oclyke/Laptop/Hardware/15TB.brd

## EAGLE design Hardware/15TB.brd (2020-11-16)

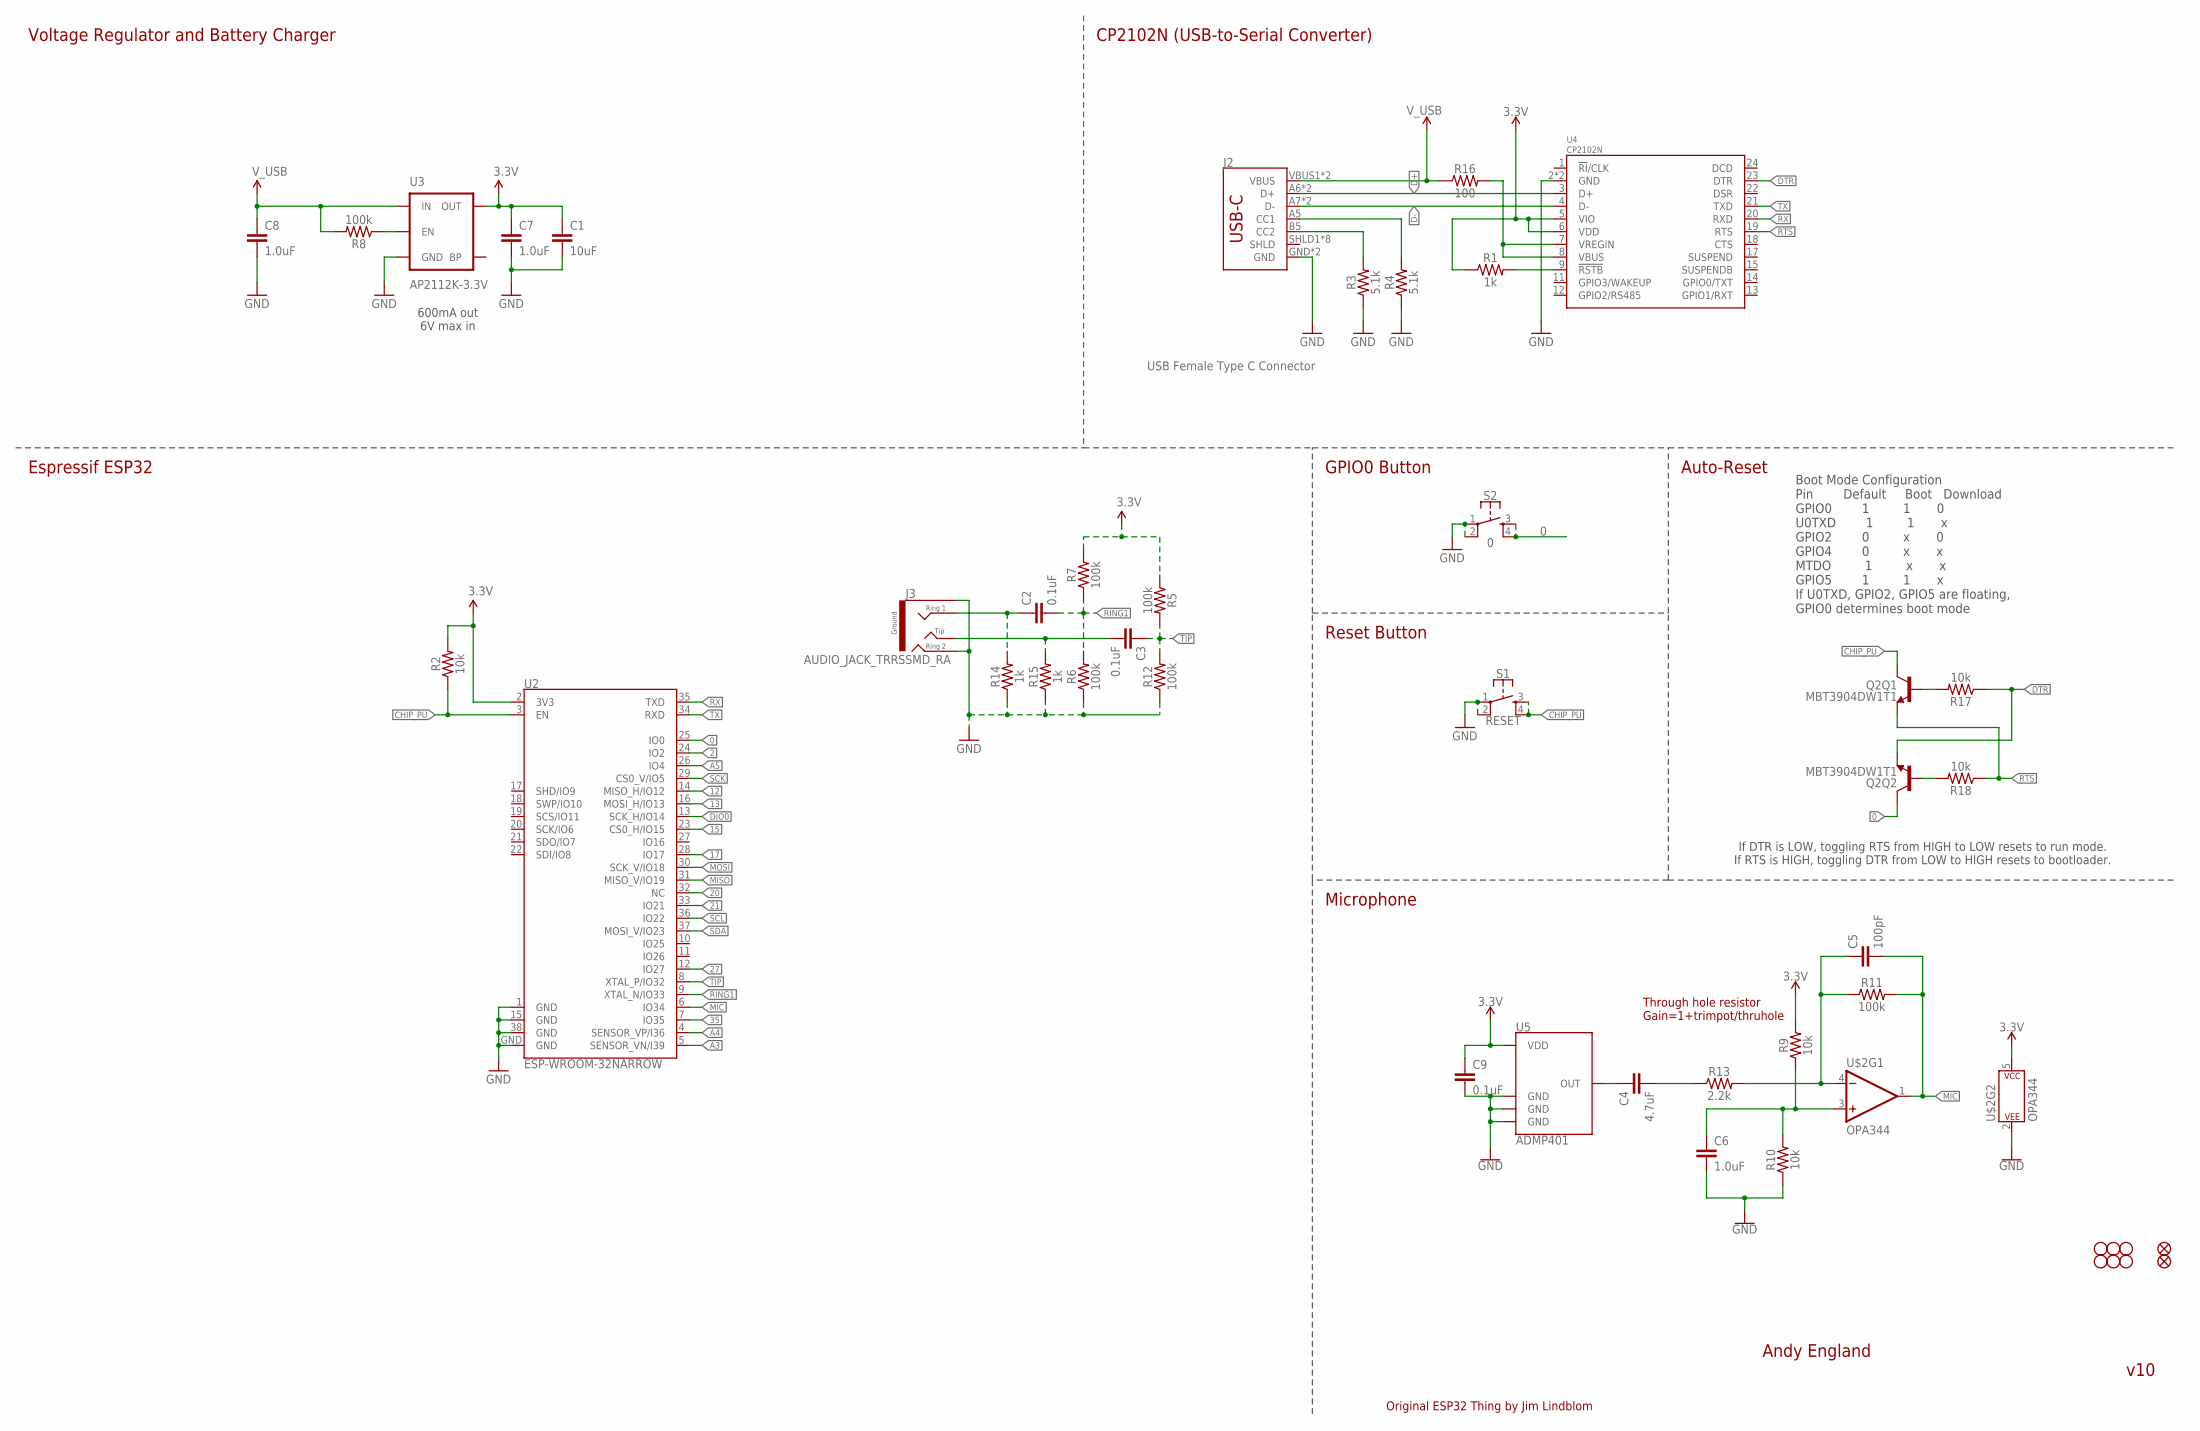
[picture p1: schematic 15TB.sch, sheet 1]

Parts:
C1: 10uF; 0603
C2, C3, C9: 0.1uF; 0603
C4: 4.7uF; 0603
C5: 100pF; 0603
C6, C7, C8: 1.0uF; 0603
FD1, FD4: FIDUCIALUFIDUCIAL; FIDUCIAL-MICRO
H1, H2, H3, H4, H5, H6: STAND-OFF
J2: USB Female Type C Connector; USB-C-16P
J3: AUDIO_JACK_TRRSSMD_RA; AUDIO_JACK_3.5MM_TRRS_SMD_RA
Q2: MBT3904DW1T1; SC70-6
R1, R14, R15: 1k; 0603
R2, R9, R10, R17, R18: 10k; 0603
R3, R4: 5.1k; 0603
R5, R6, R7, R8, R11, R12: 100k; 0603
R13: 2.2k; 0603
R16: 100; 0603
S1: RESET; TACTILE_SWITCH_SMD_4.6X2.8MM
S2: 0; TACTILE_SWITCH_SMD_4.6X2.8MM
U2: ESP-WROOM-32NARROW; ESP-WROOM-32-NARROW
U3: AP2112K-3.3V; SOT23-5
U4: CP2102N; QFN24
U5: ADMP401
U$2: OPA344; SOT23-5

Connections:
0: Q2.6 (C), S2.3, S2.4, U2.25 (IO0)
2: U2.24 (IO2)
3.3V: C1.1, C7.1, C9.1, R1.1, R2.2, R5.1, R7.2, R9.2, U2.2 (3V3), U3.5 (OUT), U4.5 (VIO), U4.6 (VDD), U5.5 (VDD), U$2.5 (P$V+)
12: U2.14 (MISO_H/IO12)
13: U2.16 (MOSI_H/IO13)
15: U2.23 (CS0_H/IO15)
17: U2.28 (IO17)
20: U2.32 (NC)
21: U2.33 (IO21)
27: U2.12 (IO27)
35: U2.7 (IO35)
A3: U2.5 (SENSOR_VN/I39)
A4: U2.4 (SENSOR_VP/I36)
A5: U2.26 (IO4)
CHIP_PU: Q2.3 (C), R2.1, S1.3, S1.4, U2.3 (EN)
D+: J2.A6 (D+), J2.B6 (D+), U4.3 (D+)
D-: J2.A7 (D-), J2.B7 (D-), U4.4 (D-)
DIO0: U2.13 (SCK_H/IO14); also elsewhere on the board
DTR: Q2.1 (E), R17.1, U4.23 (DTR)
EN: R8.1, U3.3 (EN)
GND: C1.2, C6.2, C7.2, C8.2, C9.2, J2.GND, J2.GND2 (GND), J3.EARTH, J3.RING2, R3.1, R4.1, R6.1, R10.1, R12.1, R14.1, R15.1, S1.1, S1.2, S2.1, S2.2, U2.1 (GND), U2.15 (GND), U2.38 (GND), U2.GND, U3.2 (GND), U4.2 (GND), U4.PAD (GND), U5.2 (GND), U5.4 (GND), U5.6 (GND), U$2.2 (P$V-); also elsewhere on the board
MIC: C5.2, R11.2, U2.6 (IO34), U$2.1 (OUT)
MISO: U2.31 (MISO_V/IO19)
MOSI: U2.30 (SCK_V/IO18)
unnamed: R1.2, U4.9 (!RSTB)
unnamed: J2.B5 (CC2), R3.2
unnamed: J2.A5 (CC1), R4.2
unnamed: C4.1, U5.1 (OUT)
unnamed: C3.2, J3.TIP, R15.2
unnamed: C2.1, J3.RING1, R14.2
unnamed: C5.1, R11.1, R13.2, U$2.4 (-IN)
unnamed: Q2.5 (B), R17.2
unnamed: C4.2, R13.1
unnamed: Q2.2 (B), R18.2
unnamed: C6.1, R9.1, R10.2, U$2.3 (+IN)
unnamed: R16.2, U4.7 (VREGIN), U4.8 (VBUS)
RING1: C2.2, R6.2, R7.1, U2.9 (XTAL_N/IO33)
RTS: Q2.4 (E), R18.1, U4.19 (RTS)
RX: U2.35 (TXD), U4.20 (RXD)
SCK: U2.29 (CS0_V/IO5)
SCL: U2.36 (IO22)
SDA: U2.37 (MOSI_V/IO23)
TIP: C3.1, R5.2, R12.2, U2.8 (XTAL_P/IO32)
TX: U2.34 (RXD), U4.21 (TXD)
V_USB: C8.1, J2.VBUS1 (VBUS), J2.VBUS2 (VBUS), R8.2, R16.1, U3.1 (IN); also elsewhere on the board

Notes on the sheet:
Boot Mode Configuration Pin Default Boot Download GPIO0 1 1 0 U0TXD 1 1 x GPIO2 0 x 0 GPIO4 0 x x MTDO 1 x x GPIO5 1 1 x If U0TXD, GPIO2, GPIO5 are floating, GPIO0 determines boot mode
CP2102N (USB-to-Serial Converter)
Voltage Regulator and Battery Charger
600mA out 6V max in
Auto-Reset
Espressif ESP32
Reset Button
Microphone
v10
Original ESP32 Thing by Jim Lindblom
If DTR is LOW, toggling RTS from HIGH to LOW resets to run mode. If RTS is HIGH, toggling DTR from LOW to HIGH resets to bootloader.
Andy England
GPIO0 Button
Through hole resistor Gain=1+trimpot/thruhole

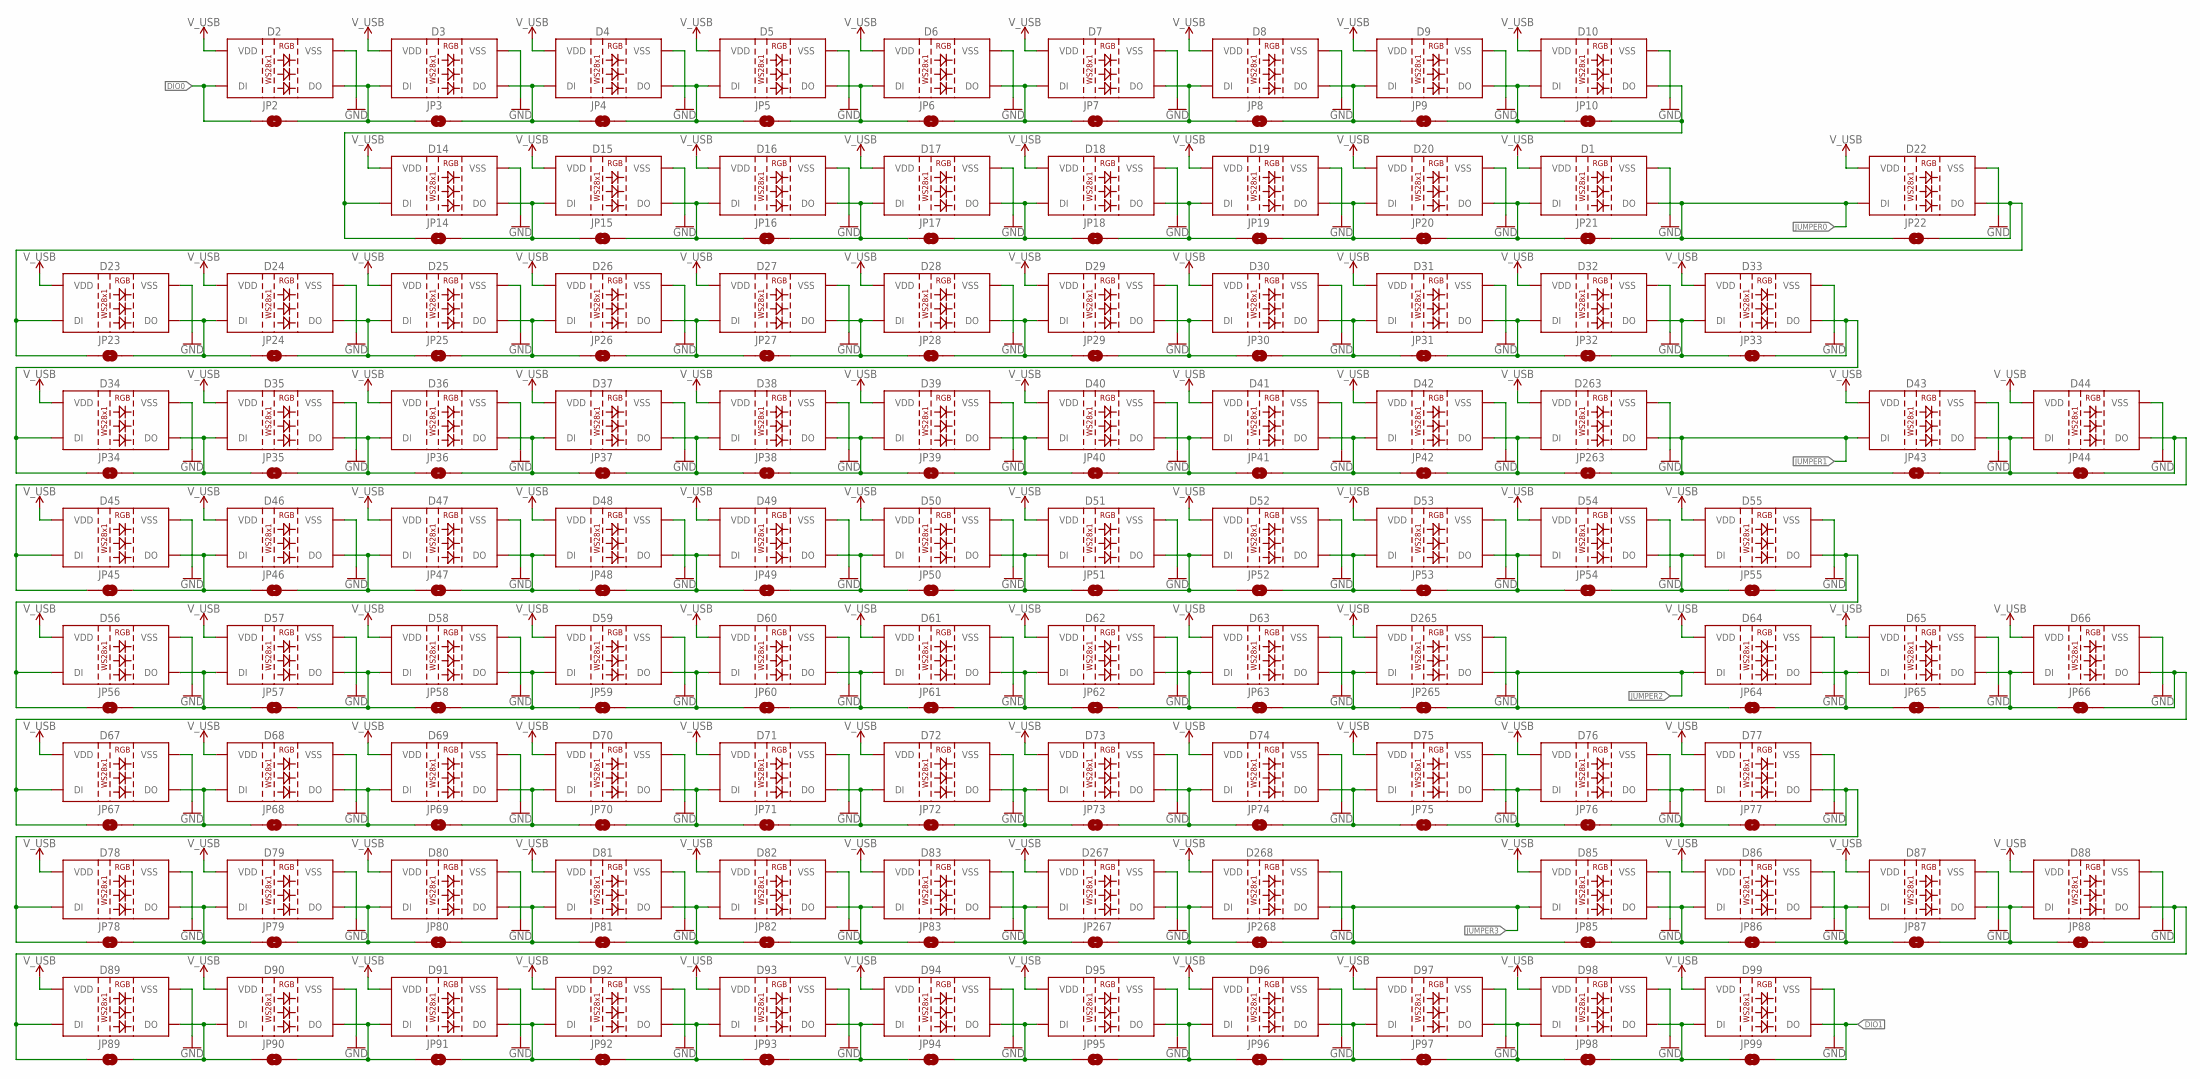
[picture p2: schematic 15TB.sch, sheet 2]

Parts:
D1, D2, D3, D4, D5, D6, D7, D8, D9, D10, D14, D15, D16, D17, D18, D19, D20, D22, D23, D24, D25, D26, D27, D28, D29, D30, D31, D32, D33, D34, D35, D36, D37, D38, D39, D40, D41, D42, D43, D44, D45, D46, D47, D48, D49, D50, D51, D52, D53, D54, D55, D56, D57, D58, D59, D60, D61, D62, D63, D64, D65, D66, D67, D68, D69, D70, D71, D72, D73, D74, D75, D76, D77, D78, D79, D80, D81, D82, D83, D85, D86, D87, D88, D89, D90, D91, D92, D93, D94, D95, D96, D97, D98, D99, D263, D265, D267, D268: WS2812B
JP2, JP3, JP4, JP5, JP6, JP7, JP8, JP9, JP10, JP14, JP15, JP16, JP17, JP18, JP19, JP20, JP21, JP22, JP23, JP24, JP25, JP26, JP27, JP28, JP29, JP30, JP31, JP32, JP33, JP34, JP35, JP36, JP37, JP38, JP39, JP40, JP41, JP42, JP43, JP44, JP45, JP46, JP47, JP48, JP49, JP50, JP51, JP52, JP53, JP54, JP55, JP56, JP57, JP58, JP59, JP60, JP61, JP62, JP63, JP64, JP65, JP66, JP67, JP68, JP69, JP70, JP71, JP72, JP73, JP74, JP75, JP76, JP77, JP78, JP79, JP80, JP81, JP82, JP83, JP85, JP86, JP87, JP88, JP89, JP90, JP91, JP92, JP93, JP94, JP95, JP96, JP97, JP98, JP99, JP263, JP265, JP267, JP268: JUMPER-SMT_2_NO_NO-SILK; SMT-JUMPER_2_NO_NO-SILK

Connections:
DIO0: D2.4 (DI), JP2.1; also elsewhere on the board
DIO1: D99.2 (DO), JP99.2; also elsewhere on the board
DIO3: D6.2 (DO), D7.4 (DI), JP6.2, JP7.1
DIO4: D8.2 (DO), D9.4 (DI), JP8.2, JP9.1
DIO7: D15.2 (DO), D16.4 (DI), JP15.2, JP16.1
DIO8: D17.2 (DO), D18.4 (DI), JP17.2, JP18.1
DIO9: D19.2 (DO), D20.4 (DI), JP19.2, JP20.1
DIO11: D22.2 (DO), D23.4 (DI), JP22.2, JP23.1
DIO12: D24.2 (DO), D25.4 (DI), JP24.2, JP25.1
DIO13: D26.2 (DO), D27.4 (DI), JP26.2, JP27.1
DIO14: D28.2 (DO), D29.4 (DI), JP28.2, JP29.1
DIO15: D30.2 (DO), D31.4 (DI), JP30.2, JP31.1
DIO16: D32.2 (DO), D33.4 (DI), JP32.2, JP33.1
DIO17: D33.2 (DO), D34.4 (DI), JP33.2, JP34.1
DIO18: D35.2 (DO), D36.4 (DI), JP35.2, JP36.1
DIO19: D37.2 (DO), D38.4 (DI), JP37.2, JP38.1
DIO20: D39.2 (DO), D40.4 (DI), JP39.2, JP40.1
DIO21: D41.2 (DO), D42.4 (DI), JP41.2, JP42.1
DIO22: D43.2 (DO), D44.4 (DI), JP43.2, JP44.1
DIO23: D44.2 (DO), D45.4 (DI), JP44.2, JP45.1
DIO24: D46.2 (DO), D47.4 (DI), JP46.2, JP47.1
DIO25: D48.2 (DO), D49.4 (DI), JP48.2, JP49.1
DIO26: D50.2 (DO), D51.4 (DI), JP50.2, JP51.1
DIO27: D52.2 (DO), D53.4 (DI), JP52.2, JP53.1
DIO28: D54.2 (DO), D55.4 (DI), JP54.2, JP55.1
DIO29: D55.2 (DO), D56.4 (DI), JP55.2, JP56.1
DIO30: D57.2 (DO), D58.4 (DI), JP57.2, JP58.1
DIO31: D59.2 (DO), D60.4 (DI), JP59.2, JP60.1
DIO32: D61.2 (DO), D62.4 (DI), JP61.2, JP62.1
DIO33: D267.2 (DO), D268.4 (DI), JP267.2, JP268.1
DIO34: D65.2 (DO), D66.4 (DI), JP65.2, JP66.1
DIO35: D66.2 (DO), D67.4 (DI), JP66.2, JP67.1
DIO36: D68.2 (DO), D69.4 (DI), JP68.2, JP69.1
DIO37: D70.2 (DO), D71.4 (DI), JP70.2, JP71.1
DIO38: D72.2 (DO), D73.4 (DI), JP72.2, JP73.1
DIO39: D74.2 (DO), D75.4 (DI), JP74.2, JP75.1
DIO40: D76.2 (DO), D77.4 (DI), JP76.2, JP77.1
DIO41: D77.2 (DO), D78.4 (DI), JP77.2, JP78.1
DIO42: D79.2 (DO), D80.4 (DI), JP79.2, JP80.1
DIO43: D81.2 (DO), D82.4 (DI), JP81.2, JP82.1
DIO45: D85.2 (DO), D86.4 (DI), JP85.2, JP86.1
DIO46: D87.2 (DO), D88.4 (DI), JP87.2, JP88.1
DIO47: D88.2 (DO), D89.4 (DI), JP88.2, JP89.1
DIO48: D90.2 (DO), D91.4 (DI), JP90.2, JP91.1
DIO49: D92.2 (DO), D93.4 (DI), JP92.2, JP93.1
DIO50: D94.2 (DO), D95.4 (DI), JP94.2, JP95.1
DIO51: D96.2 (DO), D97.4 (DI), JP96.2, JP97.1
DIO52: D98.2 (DO), D99.4 (DI), JP98.2, JP99.1
GND: D1.3 (VSS), D2.3 (VSS), D3.3 (VSS), D4.3 (VSS), D5.3 (VSS), D6.3 (VSS), D7.3 (VSS), D8.3 (VSS), D9.3 (VSS), D10.3 (VSS), D14.3 (VSS), D15.3 (VSS), D16.3 (VSS), D17.3 (VSS), D18.3 (VSS), D19.3 (VSS), D20.3 (VSS), D22.3 (VSS), D23.3 (VSS), D24.3 (VSS), D25.3 (VSS), D26.3 (VSS), D27.3 (VSS), D28.3 (VSS), D29.3 (VSS), D30.3 (VSS), D31.3 (VSS), D32.3 (VSS), D33.3 (VSS), D34.3 (VSS), D35.3 (VSS), D36.3 (VSS), D37.3 (VSS), D38.3 (VSS), D39.3 (VSS), D40.3 (VSS), D41.3 (VSS), D42.3 (VSS), D43.3 (VSS), D44.3 (VSS), D45.3 (VSS), D46.3 (VSS), D47.3 (VSS), D48.3 (VSS), D49.3 (VSS), D50.3 (VSS), D51.3 (VSS), D52.3 (VSS), D53.3 (VSS), D54.3 (VSS), D55.3 (VSS), D56.3 (VSS), D57.3 (VSS), D58.3 (VSS), D59.3 (VSS), D60.3 (VSS), D61.3 (VSS), D62.3 (VSS), D63.3 (VSS), D64.3 (VSS), D65.3 (VSS), D66.3 (VSS), D67.3 (VSS), D68.3 (VSS), D69.3 (VSS), D70.3 (VSS), D71.3 (VSS), D72.3 (VSS), D73.3 (VSS), D74.3 (VSS), D75.3 (VSS), D76.3 (VSS), D77.3 (VSS), D78.3 (VSS), D79.3 (VSS), D80.3 (VSS), D81.3 (VSS), D82.3 (VSS), D83.3 (VSS), D85.3 (VSS), D86.3 (VSS), D87.3 (VSS), D88.3 (VSS), D89.3 (VSS), D90.3 (VSS), D91.3 (VSS), D92.3 (VSS), D93.3 (VSS), D94.3 (VSS), D95.3 (VSS), D96.3 (VSS), D97.3 (VSS), D98.3 (VSS), D99.3 (VSS), D263.3 (VSS), D265.3 (VSS), D267.3 (VSS), D268.3 (VSS); also elsewhere on the board
JUMPER0: D1.2 (DO), D22.4 (DI), JP21.2, JP22.1; also elsewhere on the board
JUMPER1: D43.4 (DI), D263.2 (DO), JP43.1, JP263.2; also elsewhere on the board
JUMPER2: D64.4 (DI), D265.2 (DO), JP64.1, JP265.2; also elsewhere on the board
JUMPER3: D85.4 (DI), D268.2 (DO), JP85.1, JP268.2; also elsewhere on the board
unnamed: D1.4 (DI), D20.2 (DO), JP20.2, JP21.1
unnamed: D10.2 (DO), D14.4 (DI), JP10.2, JP14.1
unnamed: D3.2 (DO), D4.4 (DI), JP3.2, JP4.1
unnamed: D5.2 (DO), D6.4 (DI), JP5.2, JP6.1
unnamed: D9.2 (DO), D10.4 (DI), JP9.2, JP10.1
unnamed: D7.2 (DO), D8.4 (DI), JP7.2, JP8.1
unnamed: D16.2 (DO), D17.4 (DI), JP16.2, JP17.1
unnamed: D23.2 (DO), D24.4 (DI), JP23.2, JP24.1
unnamed: D14.2 (DO), D15.4 (DI), JP14.2, JP15.1
unnamed: D18.2 (DO), D19.4 (DI), JP18.2, JP19.1
unnamed: D27.2 (DO), D28.4 (DI), JP27.2, JP28.1
unnamed: D25.2 (DO), D26.4 (DI), JP25.2, JP26.1
unnamed: D31.2 (DO), D32.4 (DI), JP31.2, JP32.1
unnamed: D29.2 (DO), D30.4 (DI), JP29.2, JP30.1
unnamed: D34.2 (DO), D35.4 (DI), JP34.2, JP35.1
unnamed: D38.2 (DO), D39.4 (DI), JP38.2, JP39.1
unnamed: D36.2 (DO), D37.4 (DI), JP36.2, JP37.1
unnamed: D42.2 (DO), D263.4 (DI), JP42.2, JP263.1
unnamed: D40.2 (DO), D41.4 (DI), JP40.2, JP41.1
unnamed: D45.2 (DO), D46.4 (DI), JP45.2, JP46.1
unnamed: D49.2 (DO), D50.4 (DI), JP49.2, JP50.1
unnamed: D47.2 (DO), D48.4 (DI), JP47.2, JP48.1
unnamed: D53.2 (DO), D54.4 (DI), JP53.2, JP54.1
unnamed: D51.2 (DO), D52.4 (DI), JP51.2, JP52.1
unnamed: D56.2 (DO), D57.4 (DI), JP56.2, JP57.1
unnamed: D60.2 (DO), D61.4 (DI), JP60.2, JP61.1
unnamed: D58.2 (DO), D59.4 (DI), JP58.2, JP59.1
unnamed: D64.2 (DO), D65.4 (DI), JP64.2, JP65.1
unnamed: D62.2 (DO), D63.4 (DI), JP62.2, JP63.1
unnamed: D67.2 (DO), D68.4 (DI), JP67.2, JP68.1
unnamed: D71.2 (DO), D72.4 (DI), JP71.2, JP72.1
unnamed: D69.2 (DO), D70.4 (DI), JP69.2, JP70.1
unnamed: D75.2 (DO), D76.4 (DI), JP75.2, JP76.1
unnamed: D73.2 (DO), D74.4 (DI), JP73.2, JP74.1
unnamed: D78.2 (DO), D79.4 (DI), JP78.2, JP79.1
unnamed: D82.2 (DO), D83.4 (DI), JP82.2, JP83.1
unnamed: D80.2 (DO), D81.4 (DI), JP80.2, JP81.1
unnamed: D86.2 (DO), D87.4 (DI), JP86.2, JP87.1
unnamed: D89.2 (DO), D90.4 (DI), JP89.2, JP90.1
unnamed: D93.2 (DO), D94.4 (DI), JP93.2, JP94.1
unnamed: D91.2 (DO), D92.4 (DI), JP91.2, JP92.1
unnamed: D97.2 (DO), D98.4 (DI), JP97.2, JP98.1
unnamed: D95.2 (DO), D96.4 (DI), JP95.2, JP96.1
unnamed: D2.2 (DO), D3.4 (DI), JP2.2, JP3.1
unnamed: D4.2 (DO), D5.4 (DI), JP4.2, JP5.1
unnamed: D63.2 (DO), D265.4 (DI), JP63.2, JP265.1
unnamed: D83.2 (DO), D267.4 (DI), JP83.2, JP267.1
V_USB: D1.1 (VDD), D2.1 (VDD), D3.1 (VDD), D4.1 (VDD), D5.1 (VDD), D6.1 (VDD), D7.1 (VDD), D8.1 (VDD), D9.1 (VDD), D10.1 (VDD), D14.1 (VDD), D15.1 (VDD), D16.1 (VDD), D17.1 (VDD), D18.1 (VDD), D19.1 (VDD), D20.1 (VDD), D22.1 (VDD), D23.1 (VDD), D24.1 (VDD), D25.1 (VDD), D26.1 (VDD), D27.1 (VDD), D28.1 (VDD), D29.1 (VDD), D30.1 (VDD), D31.1 (VDD), D32.1 (VDD), D33.1 (VDD), D34.1 (VDD), D35.1 (VDD), D36.1 (VDD), D37.1 (VDD), D38.1 (VDD), D39.1 (VDD), D40.1 (VDD), D41.1 (VDD), D42.1 (VDD), D43.1 (VDD), D44.1 (VDD), D45.1 (VDD), D46.1 (VDD), D47.1 (VDD), D48.1 (VDD), D49.1 (VDD), D50.1 (VDD), D51.1 (VDD), D52.1 (VDD), D53.1 (VDD), D54.1 (VDD), D55.1 (VDD), D56.1 (VDD), D57.1 (VDD), D58.1 (VDD), D59.1 (VDD), D60.1 (VDD), D61.1 (VDD), D62.1 (VDD), D63.1 (VDD), D64.1 (VDD), D65.1 (VDD), D66.1 (VDD), D67.1 (VDD), D68.1 (VDD), D69.1 (VDD), D70.1 (VDD), D71.1 (VDD), D72.1 (VDD), D73.1 (VDD), D74.1 (VDD), D75.1 (VDD), D76.1 (VDD), D77.1 (VDD), D78.1 (VDD), D79.1 (VDD), D80.1 (VDD), D81.1 (VDD), D82.1 (VDD), D83.1 (VDD), D85.1 (VDD), D86.1 (VDD), D87.1 (VDD), D88.1 (VDD), D89.1 (VDD), D90.1 (VDD), D91.1 (VDD), D92.1 (VDD), D93.1 (VDD), D94.1 (VDD), D95.1 (VDD), D96.1 (VDD), D97.1 (VDD), D98.1 (VDD), D99.1 (VDD), D263.1 (VDD), D265.1 (VDD), D267.1 (VDD), D268.1 (VDD); also elsewhere on the board

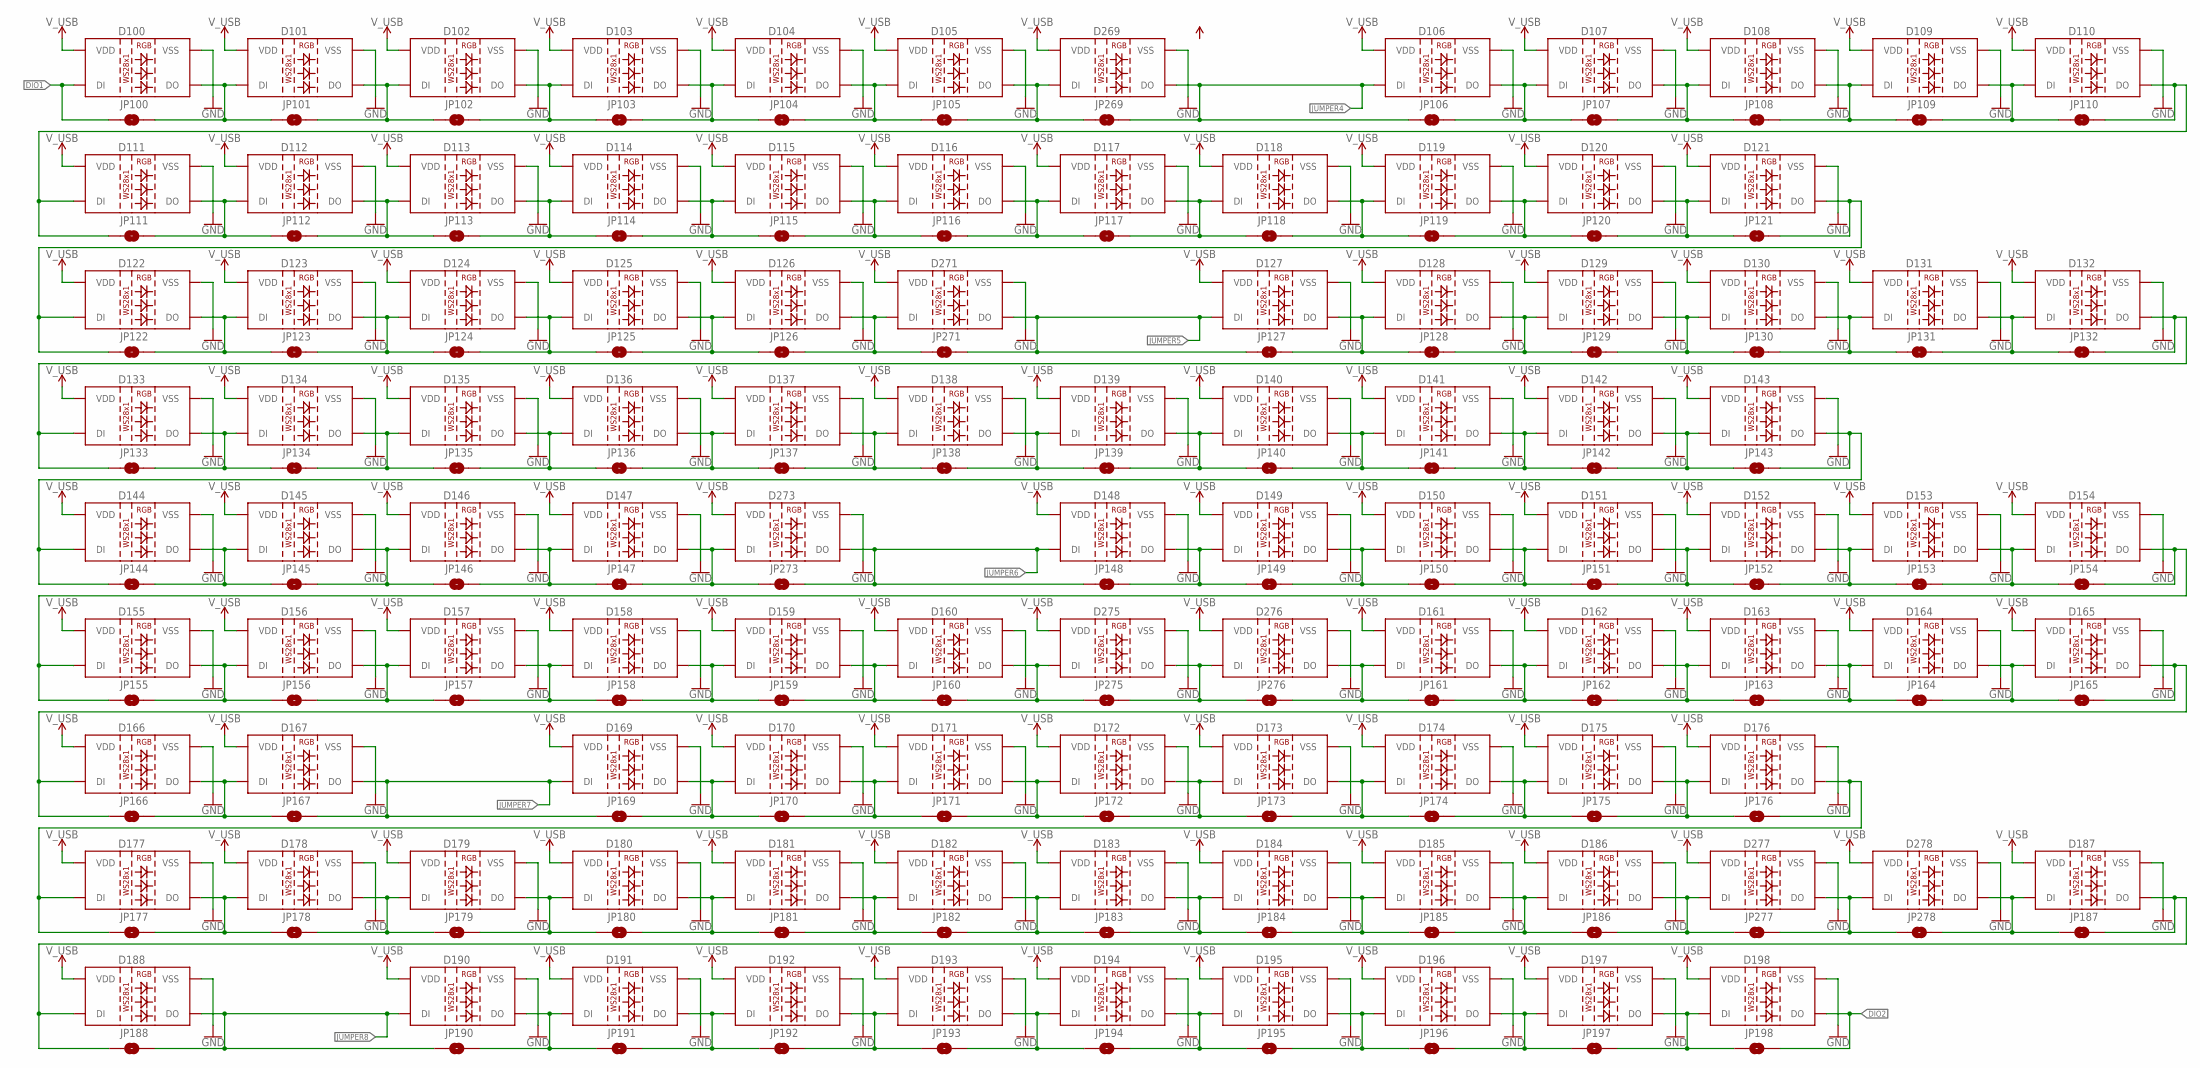
[picture p3: schematic 15TB.sch, sheet 3]

Parts:
D100, D101, D102, D103, D104, D105, D106, D107, D108, D109, D110, D111, D112, D113, D114, D115, D116, D117, D118, D119, D120, D121, D122, D123, D124, D125, D126, D127, D128, D129, D130, D131, D132, D133, D134, D135, D136, D137, D138, D139, D140, D141, D142, D143, D144, D145, D146, D147, D148, D149, D150, D151, D152, D153, D154, D155, D156, D157, D158, D159, D160, D161, D162, D163, D164, D165, D166, D167, D169, D170, D171, D172, D173, D174, D175, D176, D177, D178, D179, D180, D181, D182, D183, D184, D185, D186, D187, D188, D190, D191, D192, D193, D194, D195, D196, D197, D198, D269, D271, D273, D275, D276, D277, D278: WS2812B
JP100, JP101, JP102, JP103, JP104, JP105, JP106, JP107, JP108, JP109, JP110, JP111, JP112, JP113, JP114, JP115, JP116, JP117, JP118, JP119, JP120, JP121, JP122, JP123, JP124, JP125, JP126, JP127, JP128, JP129, JP130, JP131, JP132, JP133, JP134, JP135, JP136, JP137, JP138, JP139, JP140, JP141, JP142, JP143, JP144, JP145, JP146, JP147, JP148, JP149, JP150, JP151, JP152, JP153, JP154, JP155, JP156, JP157, JP158, JP159, JP160, JP161, JP162, JP163, JP164, JP165, JP166, JP167, JP169, JP170, JP171, JP172, JP173, JP174, JP175, JP176, JP177, JP178, JP179, JP180, JP181, JP182, JP183, JP184, JP185, JP186, JP187, JP188, JP190, JP191, JP192, JP193, JP194, JP195, JP196, JP197, JP198, JP269, JP271, JP273, JP275, JP276, JP277, JP278: JUMPER-SMT_2_NO_NO-SILK; SMT-JUMPER_2_NO_NO-SILK

Connections:
DIO1: D100.4 (DI), JP100.1; also elsewhere on the board
DIO2: D198.2 (DO), JP198.2; also elsewhere on the board
DIO53: D103.2 (DO), D104.4 (DI), JP103.2, JP104.1
DIO55: D107.2 (DO), D108.4 (DI), JP107.2, JP108.1
DIO56: D109.2 (DO), D110.4 (DI), JP109.2, JP110.1
DIO57: D112.2 (DO), D113.4 (DI), JP112.2, JP113.1
DIO58: D114.2 (DO), D115.4 (DI), JP114.2, JP115.1
DIO59: D116.2 (DO), D117.4 (DI), JP116.2, JP117.1
DIO60: D118.2 (DO), D119.4 (DI), JP118.2, JP119.1
DIO61: D120.2 (DO), D121.4 (DI), JP120.2, JP121.1
DIO62: D121.2 (DO), D122.4 (DI), JP121.2, JP122.1
DIO63: D123.2 (DO), D124.4 (DI), JP123.2, JP124.1
DIO64: D125.2 (DO), D126.4 (DI), JP125.2, JP126.1
DIO65: D127.2 (DO), D128.4 (DI), JP127.2, JP128.1
DIO66: D129.2 (DO), D130.4 (DI), JP129.2, JP130.1
DIO67: D131.2 (DO), D132.4 (DI), JP131.2, JP132.1
DIO68: D132.2 (DO), D133.4 (DI), JP132.2, JP133.1
DIO69: D134.2 (DO), D135.4 (DI), JP134.2, JP135.1
DIO70: D136.2 (DO), D137.4 (DI), JP136.2, JP137.1
DIO71: D138.2 (DO), D139.4 (DI), JP138.2, JP139.1
DIO72: D140.2 (DO), D141.4 (DI), JP140.2, JP141.1
DIO73: D142.2 (DO), D143.4 (DI), JP142.2, JP143.1
DIO74: D143.2 (DO), D144.4 (DI), JP143.2, JP144.1
DIO75: D145.2 (DO), D146.4 (DI), JP145.2, JP146.1
DIO77: D149.2 (DO), D150.4 (DI), JP149.2, JP150.1
DIO78: D151.2 (DO), D152.4 (DI), JP151.2, JP152.1
DIO79: D153.2 (DO), D154.4 (DI), JP153.2, JP154.1
DIO80: D154.2 (DO), D155.4 (DI), JP154.2, JP155.1
DIO81: D156.2 (DO), D157.4 (DI), JP156.2, JP157.1
DIO82: D158.2 (DO), D159.4 (DI), JP158.2, JP159.1
DIO83: D275.2 (DO), D276.4 (DI), JP275.2, JP276.1
DIO84: D162.2 (DO), D163.4 (DI), JP162.2, JP163.1
DIO85: D164.2 (DO), D165.4 (DI), JP164.2, JP165.1
DIO86: D165.2 (DO), D166.4 (DI), JP165.2, JP166.1
DIO88: D169.2 (DO), D170.4 (DI), JP169.2, JP170.1
DIO89: D171.2 (DO), D172.4 (DI), JP171.2, JP172.1
DIO90: D173.2 (DO), D174.4 (DI), JP173.2, JP174.1
DIO91: D175.2 (DO), D176.4 (DI), JP175.2, JP176.1
DIO92: D176.2 (DO), D177.4 (DI), JP176.2, JP177.1
DIO93: D178.2 (DO), D179.4 (DI), JP178.2, JP179.1
DIO94: D180.2 (DO), D181.4 (DI), JP180.2, JP181.1
DIO95: D182.2 (DO), D183.4 (DI), JP182.2, JP183.1
DIO96: D184.2 (DO), D185.4 (DI), JP184.2, JP185.1
DIO97: D277.2 (DO), D278.4 (DI), JP277.2, JP278.1
DIO98: D187.2 (DO), D188.4 (DI), JP187.2, JP188.1
DIO100: D191.2 (DO), D192.4 (DI), JP191.2, JP192.1
DIO101: D193.2 (DO), D194.4 (DI), JP193.2, JP194.1
DIO102: D195.2 (DO), D196.4 (DI), JP195.2, JP196.1
DIO103: D197.2 (DO), D198.4 (DI), JP197.2, JP198.1
GND: D100.3 (VSS), D101.3 (VSS), D102.3 (VSS), D103.3 (VSS), D104.3 (VSS), D105.3 (VSS), D106.3 (VSS), D107.3 (VSS), D108.3 (VSS), D109.3 (VSS), D110.3 (VSS), D111.3 (VSS), D112.3 (VSS), D113.3 (VSS), D114.3 (VSS), D115.3 (VSS), D116.3 (VSS), D117.3 (VSS), D118.3 (VSS), D119.3 (VSS), D120.3 (VSS), D121.3 (VSS), D122.3 (VSS), D123.3 (VSS), D124.3 (VSS), D125.3 (VSS), D126.3 (VSS), D127.3 (VSS), D128.3 (VSS), D129.3 (VSS), D130.3 (VSS), D131.3 (VSS), D132.3 (VSS), D133.3 (VSS), D134.3 (VSS), D135.3 (VSS), D136.3 (VSS), D137.3 (VSS), D138.3 (VSS), D139.3 (VSS), D140.3 (VSS), D141.3 (VSS), D142.3 (VSS), D143.3 (VSS), D144.3 (VSS), D145.3 (VSS), D146.3 (VSS), D147.3 (VSS), D148.3 (VSS), D149.3 (VSS), D150.3 (VSS), D151.3 (VSS), D152.3 (VSS), D153.3 (VSS), D154.3 (VSS), D155.3 (VSS), D156.3 (VSS), D157.3 (VSS), D158.3 (VSS), D159.3 (VSS), D160.3 (VSS), D161.3 (VSS), D162.3 (VSS), D163.3 (VSS), D164.3 (VSS), D165.3 (VSS), D166.3 (VSS), D167.3 (VSS), D169.3 (VSS), D170.3 (VSS), D171.3 (VSS), D172.3 (VSS), D173.3 (VSS), D174.3 (VSS), D175.3 (VSS), D176.3 (VSS), D177.3 (VSS), D178.3 (VSS), D179.3 (VSS), D180.3 (VSS), D181.3 (VSS), D182.3 (VSS), D183.3 (VSS), D184.3 (VSS), D185.3 (VSS), D186.3 (VSS), D187.3 (VSS), D188.3 (VSS), D190.3 (VSS), D191.3 (VSS), D192.3 (VSS), D193.3 (VSS), D194.3 (VSS), D195.3 (VSS), D196.3 (VSS), D197.3 (VSS), D198.3 (VSS), D269.3 (VSS), D271.3 (VSS), D273.3 (VSS), D275.3 (VSS), D276.3 (VSS), D277.3 (VSS), D278.3 (VSS); also elsewhere on the board
JUMPER4: D106.4 (DI), D269.2 (DO), JP106.1, JP269.2; also elsewhere on the board
JUMPER5: D127.4 (DI), D271.2 (DO), JP127.1, JP271.2; also elsewhere on the board
JUMPER6: D148.4 (DI), D273.2 (DO), JP148.1, JP273.2; also elsewhere on the board
JUMPER7: D167.2 (DO), D169.4 (DI), JP167.2, JP169.1; also elsewhere on the board
JUMPER8: D188.2 (DO), D190.4 (DI), JP188.2, JP190.1; also elsewhere on the board
unnamed: D100.2 (DO), D101.4 (DI), JP100.2, JP101.1
unnamed: D104.2 (DO), D105.4 (DI), JP104.2, JP105.1
unnamed: D102.2 (DO), D103.4 (DI), JP102.2, JP103.1
unnamed: D108.2 (DO), D109.4 (DI), JP108.2, JP109.1
unnamed: D106.2 (DO), D107.4 (DI), JP106.2, JP107.1
unnamed: D111.2 (DO), D112.4 (DI), JP111.2, JP112.1
unnamed: D115.2 (DO), D116.4 (DI), JP115.2, JP116.1
unnamed: D113.2 (DO), D114.4 (DI), JP113.2, JP114.1
unnamed: D119.2 (DO), D120.4 (DI), JP119.2, JP120.1
unnamed: D117.2 (DO), D118.4 (DI), JP117.2, JP118.1
unnamed: D122.2 (DO), D123.4 (DI), JP122.2, JP123.1
unnamed: D124.2 (DO), D125.4 (DI), JP124.2, JP125.1
unnamed: D130.2 (DO), D131.4 (DI), JP130.2, JP131.1
unnamed: D128.2 (DO), D129.4 (DI), JP128.2, JP129.1
unnamed: D133.2 (DO), D134.4 (DI), JP133.2, JP134.1
unnamed: D137.2 (DO), D138.4 (DI), JP137.2, JP138.1
unnamed: D135.2 (DO), D136.4 (DI), JP135.2, JP136.1
unnamed: D141.2 (DO), D142.4 (DI), JP141.2, JP142.1
unnamed: D139.2 (DO), D140.4 (DI), JP139.2, JP140.1
unnamed: D144.2 (DO), D145.4 (DI), JP144.2, JP145.1
unnamed: D148.2 (DO), D149.4 (DI), JP148.2, JP149.1
unnamed: D146.2 (DO), D147.4 (DI), JP146.2, JP147.1
unnamed: D152.2 (DO), D153.4 (DI), JP152.2, JP153.1
unnamed: D150.2 (DO), D151.4 (DI), JP150.2, JP151.1
unnamed: D155.2 (DO), D156.4 (DI), JP155.2, JP156.1
unnamed: D159.2 (DO), D160.4 (DI), JP159.2, JP160.1
unnamed: D157.2 (DO), D158.4 (DI), JP157.2, JP158.1
unnamed: D163.2 (DO), D164.4 (DI), JP163.2, JP164.1
unnamed: D161.2 (DO), D162.4 (DI), JP161.2, JP162.1
unnamed: D166.2 (DO), D167.4 (DI), JP166.2, JP167.1
unnamed: D170.2 (DO), D171.4 (DI), JP170.2, JP171.1
unnamed: D174.2 (DO), D175.4 (DI), JP174.2, JP175.1
unnamed: D172.2 (DO), D173.4 (DI), JP172.2, JP173.1
unnamed: D177.2 (DO), D178.4 (DI), JP177.2, JP178.1
unnamed: D181.2 (DO), D182.4 (DI), JP181.2, JP182.1
unnamed: D179.2 (DO), D180.4 (DI), JP179.2, JP180.1
unnamed: D185.2 (DO), D186.4 (DI), JP185.2, JP186.1
unnamed: D183.2 (DO), D184.4 (DI), JP183.2, JP184.1
unnamed: D192.2 (DO), D193.4 (DI), JP192.2, JP193.1
unnamed: D190.2 (DO), D191.4 (DI), JP190.2, JP191.1
unnamed: D196.2 (DO), D197.4 (DI), JP196.2, JP197.1
unnamed: D194.2 (DO), D195.4 (DI), JP194.2, JP195.1
unnamed: D101.2 (DO), D102.4 (DI), JP101.2, JP102.1
unnamed: D110.2 (DO), D111.4 (DI), JP110.2, JP111.1
unnamed: D105.2 (DO), D269.4 (DI), JP105.2, JP269.1
unnamed: D126.2 (DO), D271.4 (DI), JP126.2, JP271.1
unnamed: D147.2 (DO), D273.4 (DI), JP147.2, JP273.1
unnamed: D161.4 (DI), D276.2 (DO), JP161.1, JP276.2
unnamed: D160.2 (DO), D275.4 (DI), JP160.2, JP275.1
unnamed: D187.4 (DI), D278.2 (DO), JP187.1, JP278.2
unnamed: D186.2 (DO), D277.4 (DI), JP186.2, JP277.1
V_USB: D100.1 (VDD), D101.1 (VDD), D102.1 (VDD), D103.1 (VDD), D104.1 (VDD), D105.1 (VDD), D106.1 (VDD), D107.1 (VDD), D108.1 (VDD), D109.1 (VDD), D110.1 (VDD), D111.1 (VDD), D112.1 (VDD), D113.1 (VDD), D114.1 (VDD), D115.1 (VDD), D116.1 (VDD), D117.1 (VDD), D118.1 (VDD), D119.1 (VDD), D120.1 (VDD), D121.1 (VDD), D122.1 (VDD), D123.1 (VDD), D124.1 (VDD), D125.1 (VDD), D126.1 (VDD), D127.1 (VDD), D128.1 (VDD), D129.1 (VDD), D130.1 (VDD), D131.1 (VDD), D132.1 (VDD), D133.1 (VDD), D134.1 (VDD), D135.1 (VDD), D136.1 (VDD), D137.1 (VDD), D138.1 (VDD), D139.1 (VDD), D140.1 (VDD), D141.1 (VDD), D142.1 (VDD), D143.1 (VDD), D144.1 (VDD), D145.1 (VDD), D146.1 (VDD), D147.1 (VDD), D148.1 (VDD), D149.1 (VDD), D150.1 (VDD), D151.1 (VDD), D152.1 (VDD), D153.1 (VDD), D154.1 (VDD), D155.1 (VDD), D156.1 (VDD), D157.1 (VDD), D158.1 (VDD), D159.1 (VDD), D160.1 (VDD), D161.1 (VDD), D162.1 (VDD), D163.1 (VDD), D164.1 (VDD), D165.1 (VDD), D166.1 (VDD), D167.1 (VDD), D169.1 (VDD), D170.1 (VDD), D171.1 (VDD), D172.1 (VDD), D173.1 (VDD), D174.1 (VDD), D175.1 (VDD), D176.1 (VDD), D177.1 (VDD), D178.1 (VDD), D179.1 (VDD), D180.1 (VDD), D181.1 (VDD), D182.1 (VDD), D183.1 (VDD), D184.1 (VDD), D185.1 (VDD), D186.1 (VDD), D187.1 (VDD), D188.1 (VDD), D190.1 (VDD), D191.1 (VDD), D192.1 (VDD), D193.1 (VDD), D194.1 (VDD), D195.1 (VDD), D196.1 (VDD), D197.1 (VDD), D198.1 (VDD), D269.1 (VDD), D271.1 (VDD), D273.1 (VDD), D275.1 (VDD), D276.1 (VDD), D277.1 (VDD), D278.1 (VDD); also elsewhere on the board
