oclyke/Laptop/Hardware/15TB.brd

## EAGLE design Hardware/15TB.brd (continued)

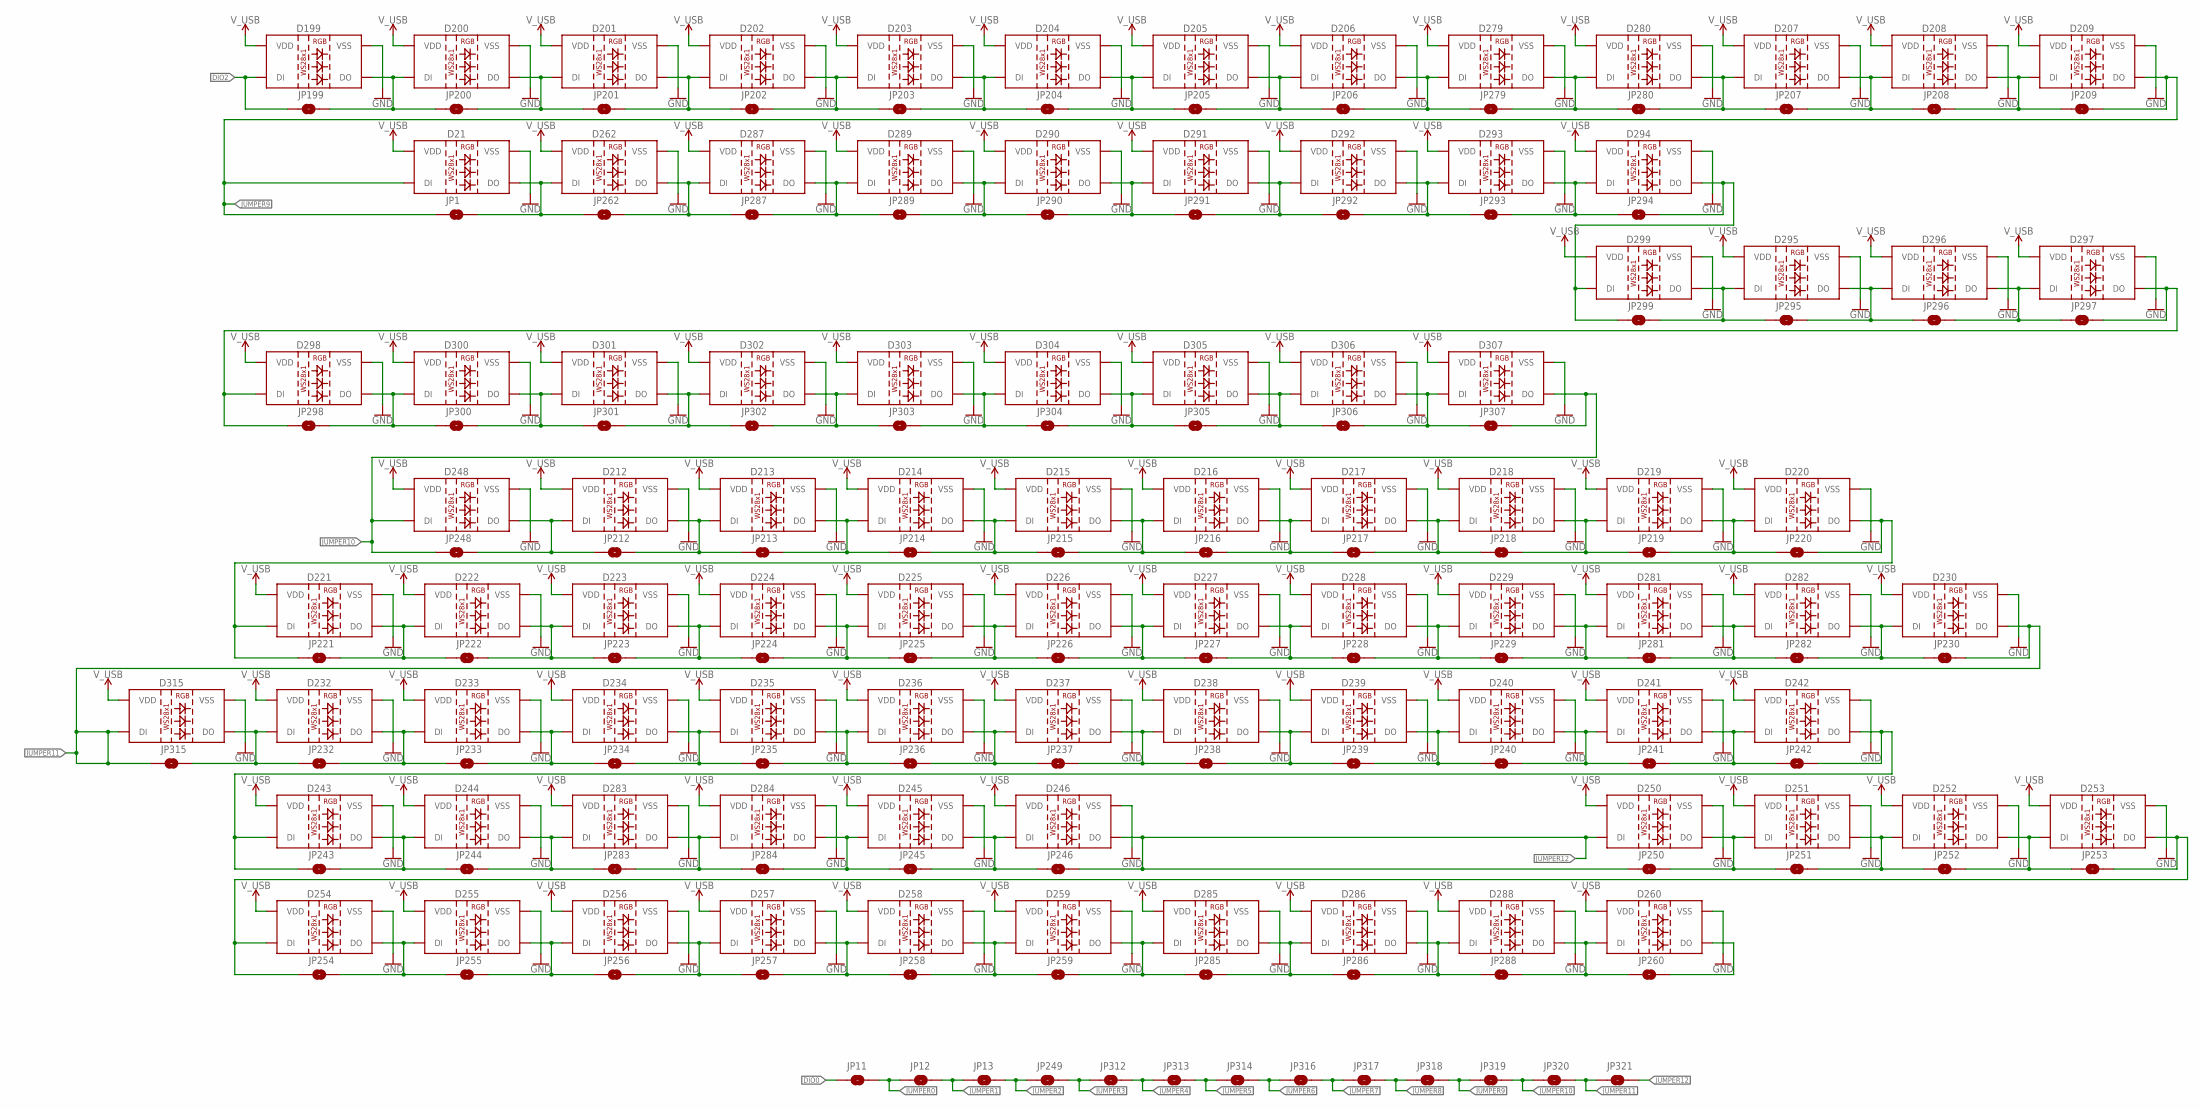
[picture p4: schematic 15TB.sch, sheet 4]

Parts:
D21, D199, D200, D201, D202, D203, D204, D205, D206, D207, D208, D209, D212, D213, D214, D215, D216, D217, D218, D219, D220, D221, D222, D223, D224, D225, D226, D227, D228, D229, D230, D232, D233, D234, D235, D236, D237, D238, D239, D240, D241, D242, D243, D244, D245, D246, D248, D250, D251, D252, D253, D254, D255, D256, D257, D258, D259, D260, D262, D279, D280, D281, D282, D283, D284, D285, D286, D287, D288, D289, D290, D291, D292, D293, D294, D295, D296, D297, D298, D299, D300, D301, D302, D303, D304, D305, D306, D307, D315: WS2812B
JP1, JP11, JP12, JP13, JP199, JP200, JP201, JP202, JP203, JP204, JP205, JP206, JP207, JP208, JP209, JP212, JP213, JP214, JP215, JP216, JP217, JP218, JP219, JP220, JP221, JP222, JP223, JP224, JP225, JP226, JP227, JP228, JP229, JP230, JP232, JP233, JP234, JP235, JP236, JP237, JP238, JP239, JP240, JP241, JP242, JP243, JP244, JP245, JP246, JP248, JP249, JP250, JP251, JP252, JP253, JP254, JP255, JP256, JP257, JP258, JP259, JP260, JP262, JP279, JP280, JP281, JP282, JP283, JP284, JP285, JP286, JP287, JP288, JP289, JP290, JP291, JP292, JP293, JP294, JP295, JP296, JP297, JP298, JP299, JP300, JP301, JP302, JP303, JP304, JP305, JP306, JP307, JP312, JP313, JP314, JP315, JP316, JP317, JP318, JP319, JP320, JP321: JUMPER-SMT_2_NO_NO-SILK; SMT-JUMPER_2_NO_NO-SILK

Connections:
DIO0: JP11.1; also elsewhere on the board
DIO2: D199.4 (DI), JP199.1; also elsewhere on the board
DIO105: D202.2 (DO), D203.4 (DI), JP202.2, JP203.1
DIO106: D204.2 (DO), D205.4 (DI), JP204.2, JP205.1
DIO107: D279.2 (DO), D280.4 (DI), JP279.2, JP280.1
DIO108: D208.2 (DO), D209.4 (DI), JP208.2, JP209.1
DIO110: D213.2 (DO), D214.4 (DI), JP213.2, JP214.1
DIO111: D215.2 (DO), D216.4 (DI), JP215.2, JP216.1
DIO112: D217.2 (DO), D218.4 (DI), JP217.2, JP218.1
DIO113: D219.2 (DO), D220.4 (DI), JP219.2, JP220.1
DIO114: D220.2 (DO), D221.4 (DI), JP220.2, JP221.1
DIO115: D222.2 (DO), D223.4 (DI), JP222.2, JP223.1
DIO116: D224.2 (DO), D225.4 (DI), JP224.2, JP225.1
DIO117: D226.2 (DO), D227.4 (DI), JP226.2, JP227.1
DIO118: D228.2 (DO), D229.4 (DI), JP228.2, JP229.1
DIO122: D233.2 (DO), D234.4 (DI), JP233.2, JP234.1
DIO123: D235.2 (DO), D236.4 (DI), JP235.2, JP236.1
DIO124: D237.2 (DO), D238.4 (DI), JP237.2, JP238.1
DIO125: D239.2 (DO), D240.4 (DI), JP239.2, JP240.1
DIO126: D241.2 (DO), D242.4 (DI), JP241.2, JP242.1
DIO128: D242.2 (DO), D243.4 (DI), JP242.2, JP243.1
DIO129: D283.2 (DO), D284.4 (DI), JP283.2, JP284.1
DIO132: D250.2 (DO), D251.4 (DI), JP250.2, JP251.1
DIO133: D252.2 (DO), D253.4 (DI), JP252.2, JP253.1
DIO134: D253.2 (DO), D254.4 (DI), JP253.2, JP254.1
DIO135: D255.2 (DO), D256.4 (DI), JP255.2, JP256.1
DIO136: D257.2 (DO), D258.4 (DI), JP257.2, JP258.1
DIO137: D285.2 (DO), D286.4 (DI), JP285.2, JP286.1
DIO138: D262.2 (DO), D287.4 (DI), JP262.2, JP287.1
DIO139: D281.2 (DO), D282.4 (DI), JP281.2, JP282.1
DIO140: D289.2 (DO), D290.4 (DI), JP289.2, JP290.1
DIO141: D291.2 (DO), D292.4 (DI), JP291.2, JP292.1
DIO142: D293.2 (DO), D294.4 (DI), JP293.2, JP294.1
DIO144: D297.2 (DO), D298.4 (DI), JP297.2, JP298.1
DIO145: D296.2 (DO), D297.4 (DI), JP296.2, JP297.1
DIO146: D298.2 (DO), D300.4 (DI), JP298.2, JP300.1
DIO147: D294.2 (DO), D299.4 (DI), JP294.2, JP299.1
DIO148: D301.2 (DO), D302.4 (DI), JP301.2, JP302.1
DIO149: D303.2 (DO), D304.4 (DI), JP303.2, JP304.1
DIO150: D305.2 (DO), D306.4 (DI), JP305.2, JP306.1
DIO153: D232.4 (DI), D315.2 (DO), JP232.1, JP315.2
GND: D21.3 (VSS), D199.3 (VSS), D200.3 (VSS), D201.3 (VSS), D202.3 (VSS), D203.3 (VSS), D204.3 (VSS), D205.3 (VSS), D206.3 (VSS), D207.3 (VSS), D208.3 (VSS), D209.3 (VSS), D212.3 (VSS), D213.3 (VSS), D214.3 (VSS), D215.3 (VSS), D216.3 (VSS), D217.3 (VSS), D218.3 (VSS), D219.3 (VSS), D220.3 (VSS), D221.3 (VSS), D222.3 (VSS), D223.3 (VSS), D224.3 (VSS), D225.3 (VSS), D226.3 (VSS), D227.3 (VSS), D228.3 (VSS), D229.3 (VSS), D230.3 (VSS), D232.3 (VSS), D233.3 (VSS), D234.3 (VSS), D235.3 (VSS), D236.3 (VSS), D237.3 (VSS), D238.3 (VSS), D239.3 (VSS), D240.3 (VSS), D241.3 (VSS), D242.3 (VSS), D243.3 (VSS), D244.3 (VSS), D245.3 (VSS), D246.3 (VSS), D248.3 (VSS), D250.3 (VSS), D251.3 (VSS), D252.3 (VSS), D253.3 (VSS), D254.3 (VSS), D255.3 (VSS), D256.3 (VSS), D257.3 (VSS), D258.3 (VSS), D259.3 (VSS), D260.3 (VSS), D262.3 (VSS), D279.3 (VSS), D280.3 (VSS), D281.3 (VSS), D282.3 (VSS), D283.3 (VSS), D284.3 (VSS), D285.3 (VSS), D286.3 (VSS), D287.3 (VSS), D288.3 (VSS), D289.3 (VSS), D290.3 (VSS), D291.3 (VSS), D292.3 (VSS), D293.3 (VSS), D294.3 (VSS), D295.3 (VSS), D296.3 (VSS), D297.3 (VSS), D298.3 (VSS), D299.3 (VSS), D300.3 (VSS), D301.3 (VSS), D302.3 (VSS), D303.3 (VSS), D304.3 (VSS), D305.3 (VSS), D306.3 (VSS), D307.3 (VSS), D315.3 (VSS); also elsewhere on the board
JUMPER0: JP11.2, JP12.1; also elsewhere on the board
JUMPER1: JP12.2, JP13.1; also elsewhere on the board
JUMPER2: JP13.2, JP249.1; also elsewhere on the board
JUMPER3: JP249.2, JP312.1; also elsewhere on the board
JUMPER4: JP312.2, JP313.1; also elsewhere on the board
JUMPER5: JP313.2, JP314.1; also elsewhere on the board
JUMPER6: JP314.2, JP316.1; also elsewhere on the board
JUMPER7: JP316.2, JP317.1; also elsewhere on the board
JUMPER8: JP317.2, JP318.1; also elsewhere on the board
JUMPER9: D21.4 (DI), D209.2 (DO), JP1.1, JP209.2, JP318.2, JP319.1
JUMPER10: D248.4 (DI), D307.2 (DO), JP248.1, JP307.2, JP319.2, JP320.1
JUMPER11: D230.2 (DO), D315.4 (DI), JP230.2, JP315.1, JP320.2, JP321.1
JUMPER12: D246.2 (DO), D250.4 (DI), JP246.2, JP250.1, JP321.2
unnamed: D199.2 (DO), D200.4 (DI), JP199.2, JP200.1
unnamed: D203.2 (DO), D204.4 (DI), JP203.2, JP204.1
unnamed: D201.2 (DO), D202.4 (DI), JP201.2, JP202.1
unnamed: D207.2 (DO), D208.4 (DI), JP207.2, JP208.1
unnamed: D205.2 (DO), D206.4 (DI), JP205.2, JP206.1
unnamed: D214.2 (DO), D215.4 (DI), JP214.2, JP215.1
unnamed: D212.2 (DO), D213.4 (DI), JP212.2, JP213.1
unnamed: D218.2 (DO), D219.4 (DI), JP218.2, JP219.1
unnamed: D216.2 (DO), D217.4 (DI), JP216.2, JP217.1
unnamed: D221.2 (DO), D222.4 (DI), JP221.2, JP222.1
unnamed: D225.2 (DO), D226.4 (DI), JP225.2, JP226.1
unnamed: D223.2 (DO), D224.4 (DI), JP223.2, JP224.1
unnamed: D230.4 (DI), D282.2 (DO), JP230.1, JP282.2
unnamed: D227.2 (DO), D228.4 (DI), JP227.2, JP228.1
unnamed: D232.2 (DO), D233.4 (DI), JP232.2, JP233.1
unnamed: D236.2 (DO), D237.4 (DI), JP236.2, JP237.1
unnamed: D234.2 (DO), D235.4 (DI), JP234.2, JP235.1
unnamed: D240.2 (DO), D241.4 (DI), JP240.2, JP241.1
unnamed: D238.2 (DO), D239.4 (DI), JP238.2, JP239.1
unnamed: D243.2 (DO), D244.4 (DI), JP243.2, JP244.1
unnamed: D212.4 (DI), D248.2 (DO), JP212.1, JP248.2
unnamed: D245.2 (DO), D246.4 (DI), JP245.2, JP246.1
unnamed: D251.2 (DO), D252.4 (DI), JP251.2, JP252.1
unnamed: D254.2 (DO), D255.4 (DI), JP254.2, JP255.1
unnamed: D258.2 (DO), D259.4 (DI), JP258.2, JP259.1
unnamed: D256.2 (DO), D257.4 (DI), JP256.2, JP257.1
unnamed: D260.2 (DO), JP260.2
unnamed: D200.2 (DO), D201.4 (DI), JP200.2, JP201.1
unnamed: D287.2 (DO), D289.4 (DI), JP287.2, JP289.1
unnamed: D207.4 (DI), D280.2 (DO), JP207.1, JP280.2
unnamed: D206.2 (DO), D279.4 (DI), JP206.2, JP279.1
unnamed: D229.2 (DO), D281.4 (DI), JP229.2, JP281.1
unnamed: D245.4 (DI), D284.2 (DO), JP245.1, JP284.2
unnamed: D244.2 (DO), D283.4 (DI), JP244.2, JP283.1
unnamed: D286.2 (DO), D288.4 (DI), JP286.2, JP288.1
unnamed: D259.2 (DO), D285.4 (DI), JP259.2, JP285.1
unnamed: D260.4 (DI), D288.2 (DO), JP260.1, JP288.2
unnamed: D21.2 (DO), D262.4 (DI), JP1.2, JP262.1
unnamed: D292.2 (DO), D293.4 (DI), JP292.2, JP293.1
unnamed: D290.2 (DO), D291.4 (DI), JP290.2, JP291.1
unnamed: D295.2 (DO), D296.4 (DI), JP295.2, JP296.1
unnamed: D295.4 (DI), D299.2 (DO), JP295.1, JP299.2
unnamed: D302.2 (DO), D303.4 (DI), JP302.2, JP303.1
unnamed: D300.2 (DO), D301.4 (DI), JP300.2, JP301.1
unnamed: D306.2 (DO), D307.4 (DI), JP306.2, JP307.1
unnamed: D304.2 (DO), D305.4 (DI), JP304.2, JP305.1
V_USB: D21.1 (VDD), D199.1 (VDD), D200.1 (VDD), D201.1 (VDD), D202.1 (VDD), D203.1 (VDD), D204.1 (VDD), D205.1 (VDD), D206.1 (VDD), D207.1 (VDD), D208.1 (VDD), D209.1 (VDD), D212.1 (VDD), D213.1 (VDD), D214.1 (VDD), D215.1 (VDD), D216.1 (VDD), D217.1 (VDD), D218.1 (VDD), D219.1 (VDD), D220.1 (VDD), D221.1 (VDD), D222.1 (VDD), D223.1 (VDD), D224.1 (VDD), D225.1 (VDD), D226.1 (VDD), D227.1 (VDD), D228.1 (VDD), D229.1 (VDD), D230.1 (VDD), D232.1 (VDD), D233.1 (VDD), D234.1 (VDD), D235.1 (VDD), D236.1 (VDD), D237.1 (VDD), D238.1 (VDD), D239.1 (VDD), D240.1 (VDD), D241.1 (VDD), D242.1 (VDD), D243.1 (VDD), D244.1 (VDD), D245.1 (VDD), D246.1 (VDD), D248.1 (VDD), D250.1 (VDD), D251.1 (VDD), D252.1 (VDD), D253.1 (VDD), D254.1 (VDD), D255.1 (VDD), D256.1 (VDD), D257.1 (VDD), D258.1 (VDD), D259.1 (VDD), D260.1 (VDD), D262.1 (VDD), D279.1 (VDD), D280.1 (VDD), D281.1 (VDD), D282.1 (VDD), D283.1 (VDD), D284.1 (VDD), D285.1 (VDD), D286.1 (VDD), D287.1 (VDD), D288.1 (VDD), D289.1 (VDD), D290.1 (VDD), D291.1 (VDD), D292.1 (VDD), D293.1 (VDD), D294.1 (VDD), D295.1 (VDD), D296.1 (VDD), D297.1 (VDD), D298.1 (VDD), D299.1 (VDD), D300.1 (VDD), D301.1 (VDD), D302.1 (VDD), D303.1 (VDD), D304.1 (VDD), D305.1 (VDD), D306.1 (VDD), D307.1 (VDD), D315.1 (VDD); also elsewhere on the board

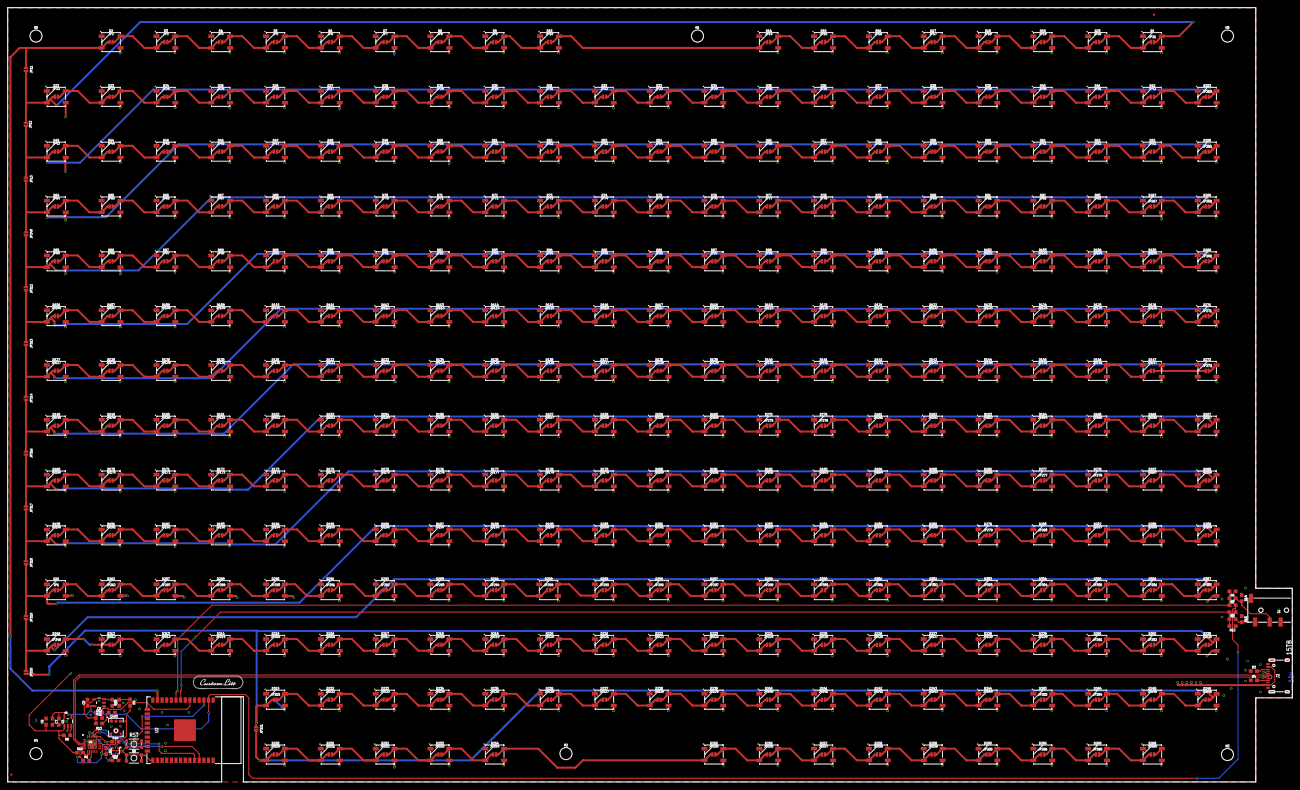
[picture p5: board 15TB.brd from above]

Board: 2 copper layers, 351.6 x 211.9 mm, 642 parts (1 on the bottom side), 319 nets.

Other parts of the board:
U$1: UNNAMED#PNG
U$3: CEC7B2_1EE547F747C2467BB1A21A2065860725_MV2#JPG
