oclyke/Laptop/Firmware/main/CustomLittBLE.cpp

/*
Copyright (c) 2020 Owen Lyke
Header: CustomLitt_BLE.h
*/

#include "CustomLittBLE.h"

#define SERVICE_UUID_CUSTOMLITT                         "9F170100-899F-4F35-AD8A-85DF24B12007"
#define CHARACTERISTIC_UUID_CL_ID                       "9F170101-899F-4F35-AD8A-85DF24B12007"

#define SERVICE_UUID_GLOBAL_PROPERTIES                  "9F170200-899F-4F35-AD8A-85DF24B12007"
#define CHARACTERISTIC_UUID_CLGP_DISPLAY_BRIGHTNESS     "9F170201-899F-4F35-AD8A-85DF24B12007"
#define CHARACTERISTIC_UUID_CLGP_AUDIO_SENSITIVITY      "9F170202-899F-4F35-AD8A-85DF24B12007"
#define CHARACTERISTIC_UUID_CLGP_AUDIO_SOURCE           "9F170203-899F-4F35-AD8A-85DF24B12007"
#define CHARACTERISTIC_UUID_CLGP_DEVICE_NAME            "9F170204-899F-4F35-AD8A-85DF24B12007"
#define CHARACTERISTIC_UUID_CLGP_NETWORK_SSID           "9F170205-899F-4F35-AD8A-85DF24B12007"
#define CHARACTERISTIC_UUID_CLGP_NETWORK_PASSWORD       "9F170206-899F-4F35-AD8A-85DF24B12007"
#define CHARACTERISTIC_UUID_CLGP_NETWORK_IP_ADDRESS     "9F170207-899F-4F35-AD8A-85DF24B12007"
#define CHARACTERISTIC_UUID_CLGP_NETWORK_STATUS         "9F170208-899F-4F35-AD8A-85DF24B12007"
#define CHARACTERISTIC_UUID_CLGP_RESET                  "9F170209-899F-4F35-AD8A-85DF24B12007"

#define SERVICE_UUID_EXPRESSION_PROPERTIES              "9F170300-899F-4F35-AD8A-85DF24B12007"
#define CHARACTERISTIC_UUID_CLEP_PATTERN                "9F170301-899F-4F35-AD8A-85DF24B12007"
#define CHARACTERISTIC_UUID_CLEP_DELAY                  "9F170302-899F-4F35-AD8A-85DF24B12007"
#define CHARACTERISTIC_UUID_CLEP_AUDIO_REACTIVITY       "9F170303-899F-4F35-AD8A-85DF24B12007"
#define CHARACTERISTIC_UUID_CLEP_FFT_BOUNDS             "9F170304-899F-4F35-AD8A-85DF24B12007"
#define CHARACTERISTIC_UUID_CLEP_COLOR                  "9F170305-899F-4F35-AD8A-85DF24B12007"
#define CHARACTERISTIC_UUID_CLEP_GRADIENT_INDEX         "9F170306-899F-4F35-AD8A-85DF24B12007"
#define CHARACTERISTIC_UUID_CLEP_GRADIENT_COLOR         "9F170307-899F-4F35-AD8A-85DF24B12007"
#define CHARACTERISTIC_UUID_CLEP_GRADIENT_BLENDING      "9F170308-899F-4F35-AD8A-85DF24B12007"

#define PROPERTY_RWN  (BLECharacteristic::PROPERTY_READ | BLECharacteristic::PROPERTY_WRITE | BLECharacteristic::PROPERTY_NOTIFY)
#define PROPERTY_RN   (BLECharacteristic::PROPERTY_READ | BLECharacteristic::PROPERTY_NOTIFY)
#define PROPERTY_WN   (BLECharacteristic::PROPERTY_WRITE | BLECharacteristic::PROPERTY_NOTIFY)
#define PROPERTY_R    (BLECharacteristic::PROPERTY_READ)
#define PROPERTY_W    (BLECharacteristic::PROPERTY_WRITE)


void setCharacteristic(BLECharacteristic *pCharacteristic, const uint8_t *buffer, size_t size){
  size_t remaining = size;
  size_t sent = 0;
  while( remaining > ESP_GATT_MAX_ATTR_LEN){
    pCharacteristic->setValue((uint8_t*)(buffer + sent), ESP_GATT_MAX_ATTR_LEN);
    pCharacteristic->notify();
    remaining -= ESP_GATT_MAX_ATTR_LEN;
    sent += ESP_GATT_MAX_ATTR_LEN;
  }
  pCharacteristic->setValue((uint8_t*)(buffer + sent), remaining);
  pCharacteristic->notify();
}

void setCharacteristic(BLECharacteristic *pCharacteristic, String string){
  const unsigned int len = string.length();
  uint8_t arry[len + 1] = {0};
  string.toCharArray((char*)arry, len + 1);
  setCharacteristic(pCharacteristic, arry, len);
}

void defaultCallback(BLECharacteristic* pCharacteristic){
  Serial.print("callback for characteristic: 0x");
  Serial.println((uint32_t)pCharacteristic, HEX);
}

void CustomLittBLECharacteristicCallbacks::onWrite(BLECharacteristic *pCharacteristic) {
  std::string val = pCharacteristic->getValue();

// // uncomment to debug all BLE write callbacks
//  for(unsigned int indi = 0; indi < val.length(); indi++){
//    Serial.print(val[indi]);
//  }
//  Serial.println();
  
  if(_p_customlittble != NULL){
    if(_callback != NULL){
      _callback(pCharacteristic);
    }
  }
}


//
// Constructor
CustomLittBLE::CustomLittBLE(void){

}

//
// Destructor
CustomLittBLE::~CustomLittBLE(void){

}

//
// begin
bool CustomLittBLE::begin(const char* localName="CustomLittBLE Server"){
  // Create the BLE Device
  BLEDevice::init(localName);

  // Create a server
  pServer = BLEDevice::createServer();
  pServer->setCallbacks(new CustomLittBLEServerCallbacks());

  // Create services
  pCustomLittService = pServer->createService(BLEUUID(SERVICE_UUID_CUSTOMLITT));
  pGlobalPropertiesService = pServer->createService(BLEUUID(SERVICE_UUID_GLOBAL_PROPERTIES), 30);
  pExpressionPropertiesService = pServer->createService(BLEUUID(SERVICE_UUID_EXPRESSION_PROPERTIES), 30);

  // Create characteristics
  // // ID Service
  pCustomLittIdCharacteristic = pCustomLittService->createCharacteristic(
                    CHARACTERISTIC_UUID_CL_ID,
                    BLECharacteristic::PROPERTY_READ
                  );

  // // Global Properties Service
  pDisplayBrightnessChar =  pGlobalPropertiesService->createCharacteristic(BLEUUID(CHARACTERISTIC_UUID_CLGP_DISPLAY_BRIGHTNESS),    PROPERTY_RWN);
  pAudioSensitivityChar =   pGlobalPropertiesService->createCharacteristic(BLEUUID(CHARACTERISTIC_UUID_CLGP_AUDIO_SENSITIVITY),     PROPERTY_RWN);
  pAudioSourceChar =        pGlobalPropertiesService->createCharacteristic(BLEUUID(CHARACTERISTIC_UUID_CLGP_AUDIO_SOURCE),          PROPERTY_RWN);
  pDeviceNameChar =         pGlobalPropertiesService->createCharacteristic(BLEUUID(CHARACTERISTIC_UUID_CLGP_DEVICE_NAME),           PROPERTY_RWN);
  pNetworkSSIDChar =        pGlobalPropertiesService->createCharacteristic(BLEUUID(CHARACTERISTIC_UUID_CLGP_NETWORK_SSID),          PROPERTY_RWN);
  pNetworkPasswordChar =    pGlobalPropertiesService->createCharacteristic(BLEUUID(CHARACTERISTIC_UUID_CLGP_NETWORK_PASSWORD),      PROPERTY_RWN);
  pNetworkIPAddressChar =   pGlobalPropertiesService->createCharacteristic(BLEUUID(CHARACTERISTIC_UUID_CLGP_NETWORK_IP_ADDRESS),    PROPERTY_RN);
  pNetworkStatusChar =      pGlobalPropertiesService->createCharacteristic(BLEUUID(CHARACTERISTIC_UUID_CLGP_NETWORK_STATUS),        PROPERTY_RWN);
  pResetChar =              pGlobalPropertiesService->createCharacteristic(BLEUUID(CHARACTERISTIC_UUID_CLGP_RESET),                 PROPERTY_W);

  pDisplayBrightnessChar->addDescriptor(new BLE2902());
  pAudioSensitivityChar->addDescriptor(new BLE2902());
  pAudioSourceChar->addDescriptor(new BLE2902());
  pDeviceNameChar->addDescriptor(new BLE2902());
  pNetworkSSIDChar->addDescriptor(new BLE2902());
  pNetworkPasswordChar->addDescriptor(new BLE2902());
  pNetworkIPAddressChar->addDescriptor(new BLE2902());
  pNetworkStatusChar->addDescriptor(new BLE2902());
//  pResetChar->addDescriptor(new BLE2902()); // reset is write-only (writing is a command to reset)

  pDisplayBrightnessChar->setCallbacks(new CustomLittBLECharacteristicCallbacks(this, &displayBrightnessCallback));
  pAudioSensitivityChar->setCallbacks(new CustomLittBLECharacteristicCallbacks(this, &audioSensitivityCallback));
  pAudioSourceChar->setCallbacks(new CustomLittBLECharacteristicCallbacks(this, &audioSourceCallback));
  pDeviceNameChar->setCallbacks(new CustomLittBLECharacteristicCallbacks(this, &deviceNameCallback));
  pNetworkSSIDChar->setCallbacks(new CustomLittBLECharacteristicCallbacks(this, &networkSSIDCallback));
  pNetworkPasswordChar->setCallbacks(new CustomLittBLECharacteristicCallbacks(this, &networkPasswordCallback));
//  pNetworkIPAddressChar->setCallbacks(new CustomLittBLECharacteristicCallbacks(this, &networkIPAddressCallback)); // ip address is read-only (it is determined by the device on artnet connect)
  pNetworkStatusChar->setCallbacks(new CustomLittBLECharacteristicCallbacks(this, &networkStatusCallback)); // network status is read-only (the device can change it at any time)
  pResetChar->setCallbacks(new CustomLittBLECharacteristicCallbacks(this, &resetCallback));

  // // Expression Properties Service
  pPatternChar =            pExpressionPropertiesService->createCharacteristic(BLEUUID(CHARACTERISTIC_UUID_CLEP_PATTERN),             PROPERTY_RWN);
  pDelayChar =              pExpressionPropertiesService->createCharacteristic(BLEUUID(CHARACTERISTIC_UUID_CLEP_DELAY),               PROPERTY_RWN);
  pAudioReactivityChar =    pExpressionPropertiesService->createCharacteristic(BLEUUID(CHARACTERISTIC_UUID_CLEP_AUDIO_REACTIVITY),    PROPERTY_RWN);
  pFFTBoundsChar =          pExpressionPropertiesService->createCharacteristic(BLEUUID(CHARACTERISTIC_UUID_CLEP_FFT_BOUNDS),          PROPERTY_RWN);
  pColorChar =              pExpressionPropertiesService->createCharacteristic(BLEUUID(CHARACTERISTIC_UUID_CLEP_COLOR),               PROPERTY_RWN);
  pGradientIndexChar =      pExpressionPropertiesService->createCharacteristic(BLEUUID(CHARACTERISTIC_UUID_CLEP_GRADIENT_INDEX),      PROPERTY_RWN);
  pGradientColorChar =      pExpressionPropertiesService->createCharacteristic(BLEUUID(CHARACTERISTIC_UUID_CLEP_GRADIENT_COLOR),      PROPERTY_RWN);
  pGradientBlendingChar =   pExpressionPropertiesService->createCharacteristic(BLEUUID(CHARACTERISTIC_UUID_CLEP_GRADIENT_BLENDING),   PROPERTY_RWN);

  pPatternChar->addDescriptor(new BLE2902());
  pDelayChar->addDescriptor(new BLE2902());
  pAudioReactivityChar->addDescriptor(new BLE2902());
  pFFTBoundsChar->addDescriptor(new BLE2902());
  pColorChar->addDescriptor(new BLE2902());
  pGradientIndexChar->addDescriptor(new BLE2902());
  pGradientColorChar->addDescriptor(new BLE2902());
  pGradientBlendingChar->addDescriptor(new BLE2902());

  pPatternChar->setCallbacks(new CustomLittBLECharacteristicCallbacks(this, &patternCallback));
  pDelayChar->setCallbacks(new CustomLittBLECharacteristicCallbacks(this, &delayCallback));
  pAudioReactivityChar->setCallbacks(new CustomLittBLECharacteristicCallbacks(this, &audioReactivityCallback));
  pFFTBoundsChar->setCallbacks(new CustomLittBLECharacteristicCallbacks(this, &fftBoundsCallback));
  pColorChar->setCallbacks(new CustomLittBLECharacteristicCallbacks(this, &colorCallback));
  pGradientIndexChar->setCallbacks(new CustomLittBLECharacteristicCallbacks(this, &gradientIndexCallback));
  pGradientColorChar->setCallbacks(new CustomLittBLECharacteristicCallbacks(this, &gradientColorCallback));
  pGradientBlendingChar->setCallbacks(new CustomLittBLECharacteristicCallbacks(this, &gradientBlendingCallback));

  // Start the service(s)
  pCustomLittService->start();
  pGlobalPropertiesService->start();
  pExpressionPropertiesService->start();

  // Start advertising
  pServer->getAdvertising()->addServiceUUID(SERVICE_UUID_CUSTOMLITT);
  pServer->getAdvertising()->start();
  return true;
}



void CustomLittBLE::setDisplayBrightness(uint8_t brightness){  
  setCharacteristic(pDisplayBrightnessChar, String(brightness));
}

void CustomLittBLE::setAudioSensitivity(float sensitivity){
  setCharacteristic(pAudioSensitivityChar, String(sensitivity));
}

void CustomLittBLE::setAudioSource(uint8_t source){
  setCharacteristic(pAudioSourceChar, String(source));
}

void CustomLittBLE::setDeviceName(String name){
  setCharacteristic(pDeviceNameChar, name);
}

void CustomLittBLE::setNetworkSSID(String ssid){
  setCharacteristic(pNetworkSSIDChar, ssid);
}

void CustomLittBLE::setNetworkPassword(String password){
  setCharacteristic(pNetworkPasswordChar, password);
}

void CustomLittBLE::setIPAddress(IPAddress address){  
  setCharacteristic(pNetworkIPAddressChar, address.toString());
}

void CustomLittBLE::setNetworkStatus(bool status){
  setCharacteristic(pNetworkStatusChar, String((uint8_t)status));
}



void CustomLittBLE::setPattern(uint8_t pattern){
  setCharacteristic(pPatternChar, String(pattern));
}

void CustomLittBLE::setDelay(uint8_t frames, uint16_t ms){
  setCharacteristic(pDelayChar, String(frames) + " " + String(ms));
}

void CustomLittBLE::setAudioReactivity(uint8_t reactivity){
  setCharacteristic(pAudioReactivityChar, String(reactivity));
}

void CustomLittBLE::setFFTBounds(uint8_t low, uint8_t high){
  setCharacteristic(pFFTBoundsChar, String(low) + " " + String(high));
}

void CustomLittBLE::setColor(uint8_t r, uint8_t g, uint8_t b){
  setCharacteristic(pColorChar, String(r) + " " + String(g) + " " + String(b));
}

void CustomLittBLE::setGradientIndex(uint8_t index){
  setCharacteristic(pGradientIndexChar, String(index));
}

void CustomLittBLE::setGradientColor(uint8_t r, uint8_t g, uint8_t b){
  setCharacteristic(pGradientColorChar, String(r) + " " + String(g) + " " + String(b));
}

void CustomLittBLE::setGradientBlending(uint8_t blending){
  setCharacteristic(pGradientBlendingChar, String(blending));
}
