oclyke/Laptop/(commit log)

2019-05-08 initial board layout
    [ESP32_Thing_Plus.brd, ESP32_Thing_Plus.sch]
2019-07-08 updating mic and trrs circuits
    [ESP32_Thing_Plus.GBL, ESP32_Thing_Plus.GBO, ESP32_Thing_Plus.GBS, ESP32_Thing_Plus.GKO, ESP32_Thing_Plus.GTL, ESP32_Thing_Plus.GTO, ESP32_Thing_Plus.GTP, ESP32_Thing_Plus.GTS]
2019-07-24 changing to 0603
    [ESP32_Thing_Plus.brd, ESP32_Thing_Plus.sch]
2019-10-01 partially through layout
    [ESP32_Thing_Plus.GBL, ESP32_Thing_Plus.GBO, ESP32_Thing_Plus.GBS, ESP32_Thing_Plus.GKO, ESP32_Thing_Plus.GTL, ESP32_Thing_Plus.GTO, ESP32_Thing_Plus.GTP, ESP32_Thing_Plus.GTS]
2019-10-02 updating layout, fixing bad commit
    [ESP32_Thing_Plus.brd, ESP32_Thing_Plus.sch]
2019-10-04 completing initial 13 in layout, ready for design review with jason
    [ESP32_Thing_Plus.brd, ESP32_Thing_Plus.sch]
2019-10-09 13 inch v01 laid out, ready to order
    [13NR.GBL, 13NR.GBO, 13NR.GBS, 13NR.GKO, 13NR.GTL, 13NR.GTO, 13NR.GTP, 13NR.GTS]
2019-10-17 updating 13NR, to move for mounting stuff
    [13NR.brd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]
2019-10-18 moving power to other side
    [13NR.brd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]
2019-10-22 strange gerber issue, counting a trace on dimension layer
    [13NR.brd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]
2019-11-20 most of barebones backedn finished
    [13NR.brd]
2019-12-16 updating firmware, fixing repo on computer
    [AudioTest.ino, bluetoothInterface.ino, patterns.ino]
2019-12-17 fixing hard reset when pulling bad values fromEEPROMfor SSID/Password
    [EEPROMHandle.ino, dmxHandler.ino]
2019-12-21 switch to BLE interface for serial
    drop-in replacement for the old "BluetoothSerial.h"
    most commonly used functions are implemented, more could be added later if needed
    tested very well for typical length transmissions
    poor test setup may have caused/contributed to dropped characters after ~231 bytes, may need additional investigation
    [main.ino]
2019-12-28 reverting back to old firmware for a second
    [main.ino]
2020-01-01 updating a few patterns, adding in framedelay, frameskip
2020-01-02 temporary initartnet fix for when wifi not connected properly
    [dmxHandler.ino, main.ino]
2020-01-02 add CustomLitt uuid for filtering
2020-01-03 adding in left/right for mic capability
    [15R.brd, 15R.sch]
2020-02-05 adding deviceName, updating some functions like audio reaction and blending to not be state dependent
2020-02-05 starting to reroute 15 inch model
    [15R.brd]
2020-02-07 routing 15 inch
    [15R.brd, 15R.sch]
2020-02-10 updating 13 inch, finish layout of 15 inch
    [15R.brd, 15R.sch, BASE.brd, BASE.sch]
2020-02-11 getting closer to final 15 inch layout
    [BASE.brd, BASE.sch]
2020-02-27 final airwires on 13 inch retina, need to copy and move holes
    [13R.brd, 13R.sch, BASE.brd]
2020-02-29 updating 15TB outer dimensions, still need to re-place holes
    [13NR.brd, 13NR.sch, 13TB.brd, 13TB.sch, 15NR.brd, 15NR.sch, 15TB.brd, 15TB.sch]
2020-03-03 updating 13NR
    [13NR.brd, 13NR.sch, 13R.brd]
2020-03-11 getting 4 boards polished
    [13R.brd, 13TB.brd, 13TB.sch, 15NR.brd, 15NR.sch, 15R.brd, 15R.sch, 15TB.brd]
2020-03-12 polishing 13tb and 13r
    [13R.brd, 13R.sch, 13TB.brd, 13TB.sch]
2020-03-16 final touches, polishing, jumpers, CAM on all boards
    [13NR.GBL, 13NR.GBP, 13NR.GBS, 13NR.GKO, 13NR.GTL, 13NR.GTO, 13NR.GTP, 13NR.GTS]
2020-06-26 change gradient control scheme
    this makes it so that the current gradient index can be specified
    when the index is specified the value of the gradient color characteristic is updated to match
    the gradient color can then be read
    this allows the controlling device to poll the gradient on its own time
2020-07-15 update EEPROM to use Preferences library
    Also includes fixes so that device name, ssid, and password are correctly communicated
    [EEPROMHandle.h, EEPROMHandle.ino, bluetoothInterface.ino, dmxHandler.ino, main.ino]
2020-07-16 change network status characteristic to RWN
    Read: indicate actual network status of device
    Write: request a change in network status
    (notifications occur when device changes network status)
2020-07-28 add recovery strapping pin
    temporary recovery option for #10
2020-10-16 pushing final board changes
    [13NR.GBL, 13NR.GBO, 13NR.GBS, 13NR.GKO, 13NR.GTL, 13NR.GTO, 13NR.GTP, 13NR.GTS]
2020-11-16 updating files
    [13NR.brd, 13NR.sch, 13NR_btm.csv, 13R.brd, 13R.sch, 13R_btm.csv, 13TB.brd, 13TB.sch]
